chenhongbin1994/autool/辅助资料/模组驱动/USB/README.TXT

实验器材:
	战舰STM32F103开发板V3版本
	
实验目的:
	学习STM32的USB功能使用,实现一个USB虚拟串口功能.
	
硬件资源:
	1,DS0(连接在PB5)
	2,串口1(波特率:115200,PA9/PA10连接在板载USB转串口芯片CH340上面
	3,ALIENTEK 2.8/3.5/4.3/7寸TFTLCD模块(通过FSMC驱动,FSMC_NE4接LCD片选/A10接RS) 
	4,USB_SLAVE接口(通过跳线帽将D-/D+连接在PA11/PA12上)
	
实验现象:
	本实验，利用STM32自带的USB功能,连接电脑USB,虚拟出一个USB串口，实现电脑和开发板的数据通信。
	本例程功能完全同实验4（串口实验），只不过串口变成了STM32的USB虚拟串口。当USB连接电脑（USB
	线插入USB_SLAVE接口），开发板将通过USB和电脑建立连接虚拟出一个串口（注意：需要先安装:光盘
	\6，软件资料\1，软件\STM32 USB虚拟串口驱动\VCP_V1.4.0_Setup.exe这个驱动软件），USB和电脑
	连接成功后，DS1常亮。在找到虚拟串口后，即可打开串口调试助手，实现同实验4一样的功能，即：
	STM32通过USB虚拟串口和上位机对话，STM32在收到上位机发过来的字符串（以回车换行结束）后，原原
	本本的返回给上位机。下载后，DS0闪烁，提示程序在运行，同时每隔一定时间，通过USB虚拟串口输出一
	段信息到电脑。  
	
注意事项:
	1,4.3寸和7寸屏需要比较大电流,USB供电可能不足,请用外部电源适配器(推荐外接12V 1A电源).
	2,本例程在LCD_Init函数里面(在ILI93xx.c),用到了printf,如果不初始化串口1,将导致液晶无法显示!!
	3,本实验需安装:光盘\6，软件资料\1，软件\STM32 USB虚拟串口驱动\VCP_V1.4.0_Setup.exe这个驱动
	4,如果电脑显示驱动安装不正常（有惊叹号），请手动选择驱动安装，驱动路径（以WIN7系统为例）：C:\
	  Program Files (x86)\STMicroelectronics\Software\Virtual comport driver\Win7
	5,本例程USB线需要插在:USB_SLAVE,并确保P9的D-/D+通过跳线帽连接在PA11/PA12.

-------------------------------------------------------------------------------------------
◆其他重要连接：
  开发板光盘资料下载地址（视频+文档+源码等）：http://www.openedv.com/posts/list/13912.htm
  添加微信公众平台方法：http://www.openedv.com/posts/list/45157.htm

◆友情提示：如果您想以后及时免费的收到正点原子所有开发板资料更新增加通知，请关注微信公众平台：

 2种添加方法：（动动手提升您的学习效率，惊喜不断哦）
（1）打开微信->添加朋友->公众号->输入“正点原子”->点击关注
（2）打开微信->添加朋友->输入“alientek_stm32"->点击关注

 具体微信添加方法，请参考帖子：http://www.openedv.com/posts/list/45157.htm

			正点原子@ALIENTEK 
			广州市星翼电子科技有限公司
			电话：020-38271790
			传真：020-36773971
			购买：http://eboard.taobao.com
			公司网站：www.alientek.com
			技术论坛：www.openedv.com
