chenhongbin1994/autool/PT50摩托车四缸平衡仪表/按键逻辑.docx

按键0控制：POWER 单击开/关背光、长按开/关机

按键1控制：UP 单击向上翻动，长按开关蜂鸣器

按键2控制：REC 点按进入REC模式，再次点按为保存数据；长按进入查看历史数 据，再次单击REC键进入子模式查看最大最小值和差值

按键3控制：LOCK 单击锁定和解锁数据，长按保存OK；

按键4控制：DOWN 单击向下翻动、长按进入设置模式：

a.允许切换单位

b.设置2T和4T的模式

C.是否开启自动关机功能

在设置模式中，通过按键二和按键五向上、向下翻动切换锁定的通道， 在设置模式下长按按键3保存设置结果并跳到下一个设置项；

按键5控制：P=0 单击ZERO清除时间计时、长按P=0，在历史数据模式下长按清除历史数据

Bootloader按键逻辑

按键0控制：POWER 单击开关背光，长按开关机

按键1控制：UP

按键2控制：REC 单击开始更新固件

按键3控制：LOCK 单击开始执行flash APP，长按开始执行SRAM APP

按键4控制：DOWN

按键5控制：P=0 单击固件清除完成
