chenhongbin1994/autool/辅助资料/C391040_蜂鸣器_FUET-9045_规格书_FUET(福声科技)蜂鸣器规格书(1).PDF

泰州福声电子科技有限公司-----电声产品专业制造商
FUSHENG ELECTRONICS------Acoustic Components Professional Manufacturer

FST-9045

## SPECIFICATION OF PRODUCT 承 认 书

CUSTOMER:

DESCRIPTION： | Magnetic Buzzer
FUSHENG P/N: | FUET-9045

CUSTOMER P/N:

DATE： | 2018-8-28
CUSTOMER | APPROVER | CHECKER
| Yunqing Wu | Bing Yan

泰州福声电子科技有限公司

地址:江苏省泰州市海陵区凤凰西路168 号
电话：0086-523-86219066传真：0086-523-81601108 邮箱: sales@electronic-tech.cn 网址：www.tzfsdz.com

### 1.SPECIFICATION 规格

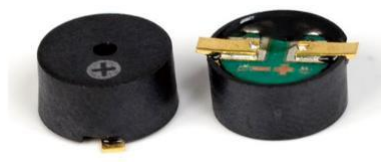
[picture p1: figure]

No. | Item | Unit | Specification | Condition
1 | Oscillation Frequency | Hz | 2700 | Vo-p=1/2duty ,square wave
2 | Operating Voltage | Vo-p | 2 ~ 4
3 | Rated Voltage | Vo-p | 3
4 | Current Consumption | mA | MAX. 80 | at Rated Voltage
5 | Sound Pressure Level | dB | MIN. 85 | at 10cm at Rated Voltage
6 | Coil Resistance | Ω | 16±3
7 | Operating Temperature | ℃ | -20 ~ +70
8 | Storage Temperature | ℃ | -30 ~ +80
9 | Dimension | mm | 9 xH4.5 | See appearance drawing
10 | Weight (MAX) | gram | 0.8
11 | Housing Material | | LCP( Black )
12 | Leading Pin | | Tin Plated Brass(Sn) | See appearance drawing
13 | Environmental Protection Regulation | | RoHS

### 2. APPEARANCE DRAWING 尺寸图

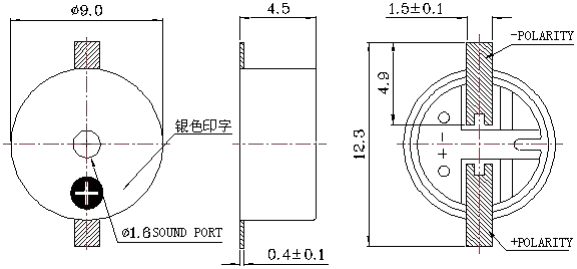
[picture p2: figure]

Tol:± 0.5 Unit:mm

### 3.TESTING METHOD 测量方式 Standard Measurement conditions

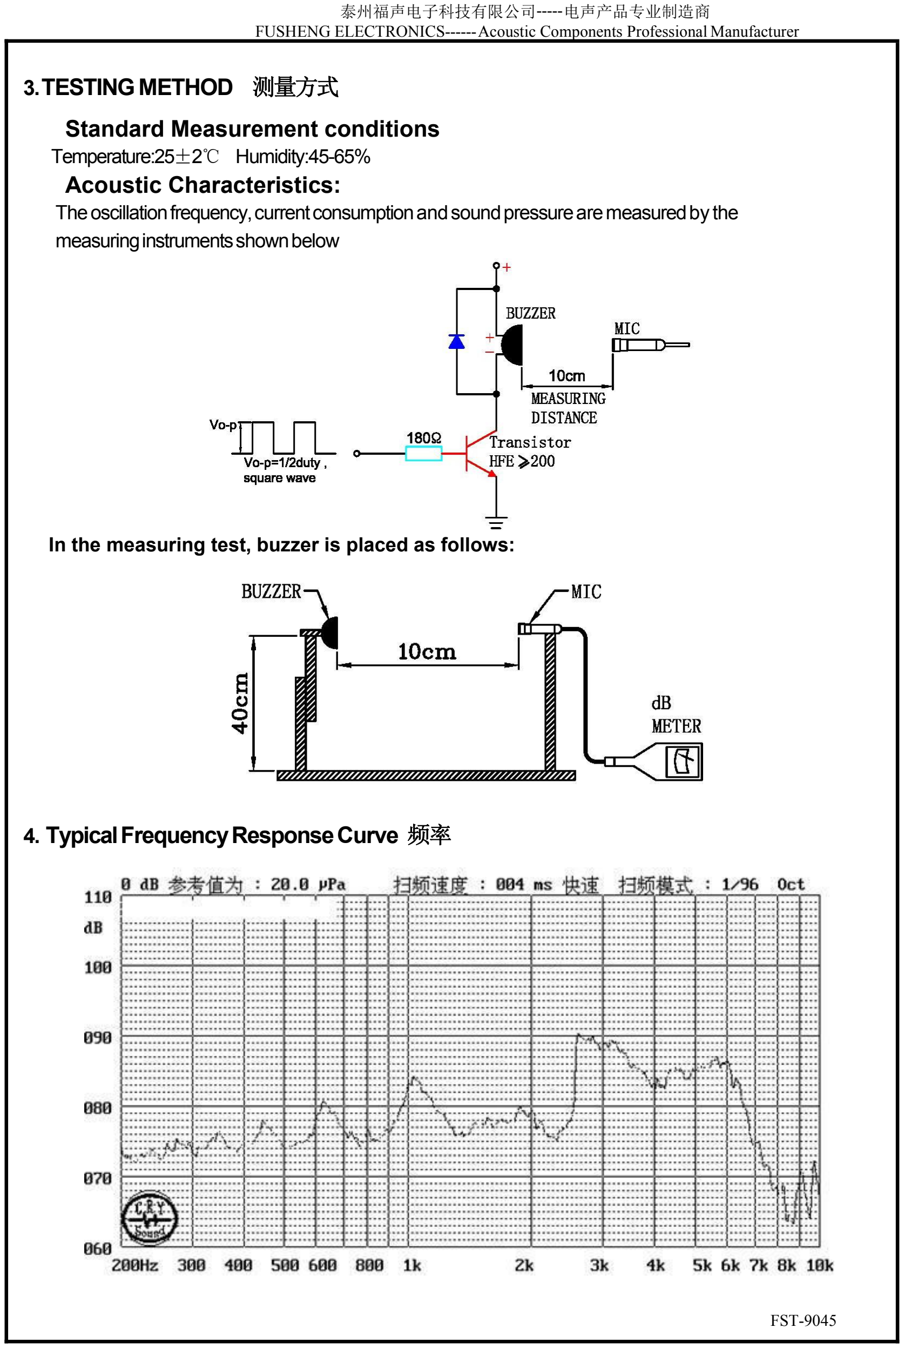
[picture p3: page 3]

Temperature:25±2℃ Humidity:45-65%

### Acoustic Characteristics:

Theoscillationfrequency,currentconsumptionandsoundpressurearemeasuredby the measuringinstrumentsshownbelow

In the measuring test, buzzer is placed as follows:

### 4. TypicalFrequencyResponseCurve 频率

### 5. Recommend DrivingCircuit

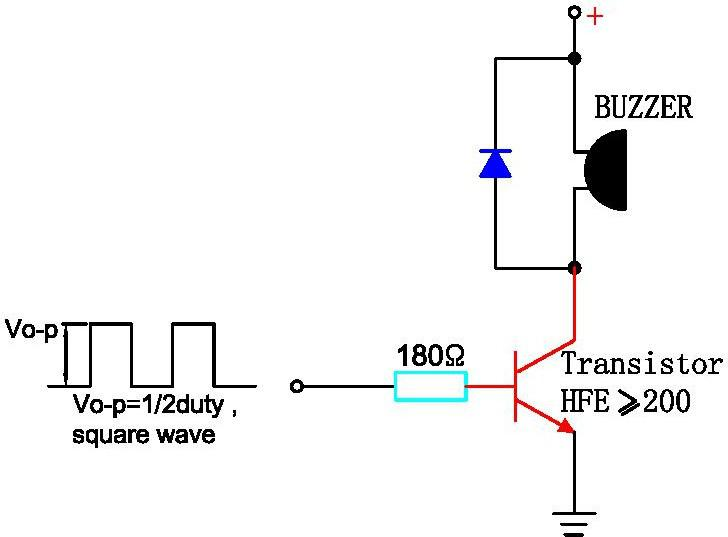
[picture p4: figure]

### Thebase currentIbshouldhighenoughso thatitsaturatesthe collectorcurrentofthe transistor

### withtheCBload. 6. SolderingCondition

(1)Recommendablereflowsolderingconditionis as follows (Reflowsolderingis twice)
Note:Itis requestedthatreflowsolderingshouldbeexecuted afterheatofproductgoesdownto normal.

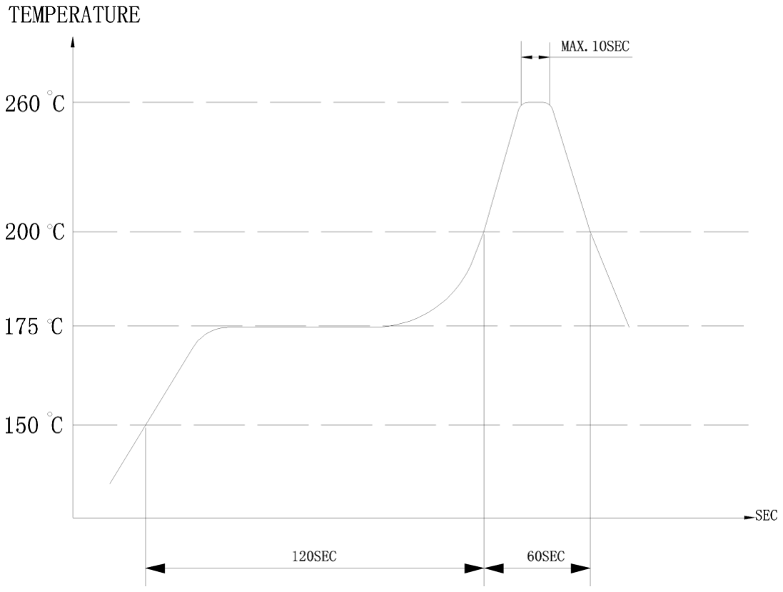
[picture p5: figure]

Heat resistant line
(Usedwhenheatresistantreliabilitytestis performed) (2)Manualsoldering
Manual soldering temperature 350 ºC within 5 sec.

### 7. RELIABILITYTEST 可靠性测试

NO. | ITEM | TEST CONDITION AND REQUIREMENT
1 | High Temperature Low Temperature Test(Storage) | Afterbeingplacedina chamberwith80 2ºCfor96hoursandthen beingplacedinnormalconditionfor2 hours. AllowablevariationofSPLaftertest: 10dB. 2
| Humidity Test Test(Storage) | AfterbeingPlacedina chamberwith-30 2ºCfor96hoursandthen beingplacedinnormalconditionfor2 hours. AllowablevariationofSPLaftertest: 10dB. 3
| | AfterbeingPlacedina chamberwith90-95%R.H.at40 2ºC for96 hoursandthenbeingplacedinnormalconditionfor2 hours. AllowablevariationofSPLaftertest: 10dB.
4 | TemperatureCycle Test Drop Test | The part shall be subjected to 5 cycles. One cycle shall be consist of： +70ºC +25ºC +25ºC - 20ºC AllowablevariationofSPLaftertest: 10dB. 5

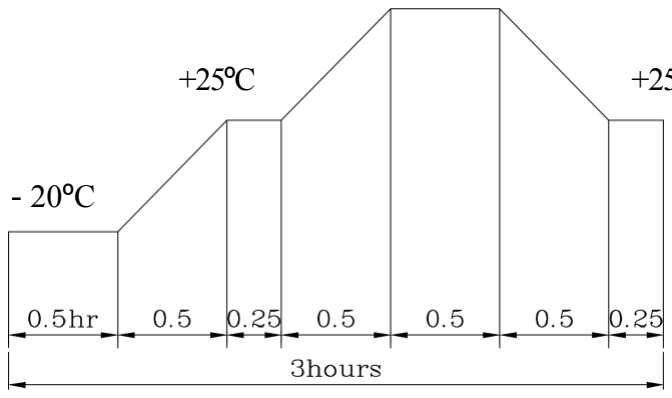
[picture p6: figure]

| Vibration Test | Dropona hardwoodboardof4cmthick,anydirections,6times, attheheightof75cm. AllowablevariationofSPLaftertest: 10dB. 6
Solderability | Afterbeingappliedvibrationof amplitudeof1.5mmwith10to55Hz band of vibration frequency to each of 3 perpendicular directionsfor 2hours. AllowablevariationofSPLaftertest: 10dB. 7
Test TerminalStrength | Lead terminals are immersed in rosin for 5 seconds and then immersedinsolderbathof+300 5ºCfor3 1seconds. 90%min.leadterminalsshallbewetwithsolder (Excepttheedgeofterminals). 8
PullingTest | Theforceof9.8N(1.0kg)is appliedtoeachterminalinaxialdirectionfor 10seconds. No visible damage and cutting off. TEST CONDITION. Standard Test Condition 一般测试条件

JudgmentTestCondition
争议时测试条件
: | a)Temperature: +5~ +35℃ b) Humidity : 45-85% c) Pressure : 860-1060mbar
: | a) 温度 : +5 ~ +35℃ | b) 湿度 : 45-85% | c) 气压 : 860-1060mbar
: | a) Temperature: +25 ± 2℃ b) Humidity : 60-70% c) Pressure : 860-1060mbar
: | a) 温度 : +25 ± 2℃ | b) 湿度 : 60-70% | c) 气压 : 860-1060mbar

### 8. PACKINGSTANDARD 包装

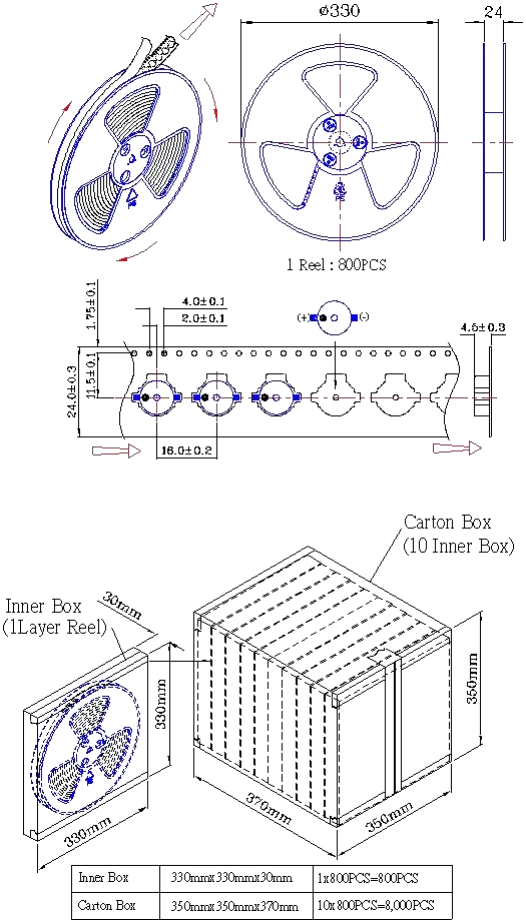
[picture p7: figure]
