chenhongbin1994/autool/PT50摩托车四缸平衡仪表/HT1623断码屏/四缸平衡UI.jpg

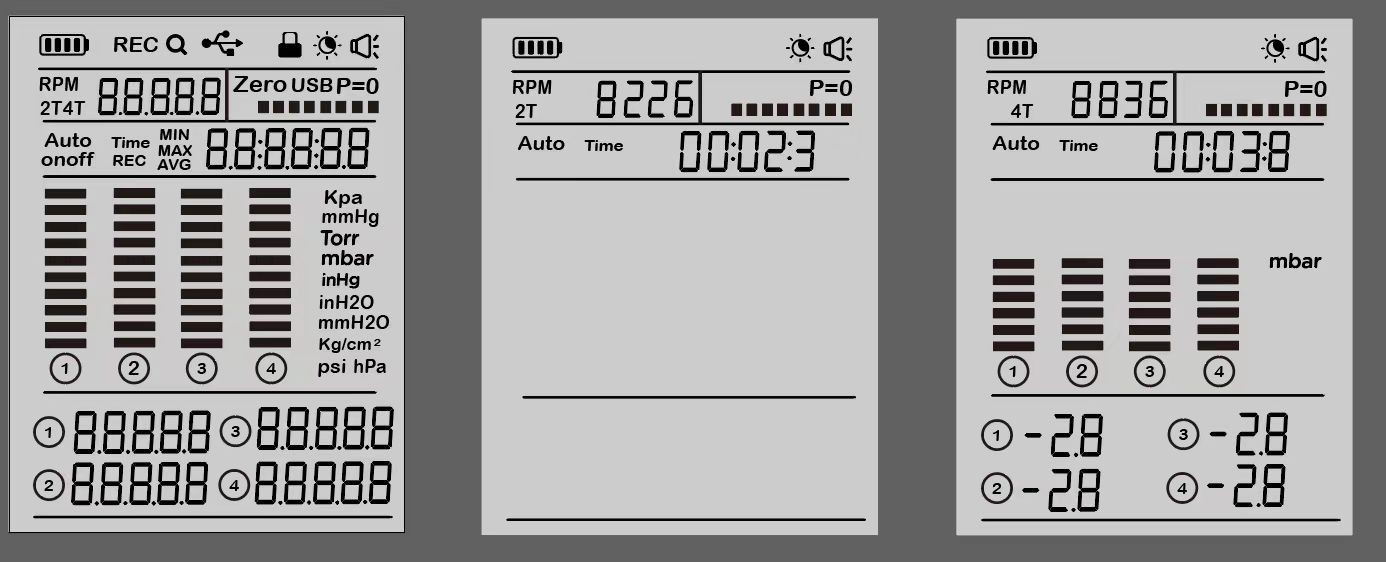
PT50摩托车四缸平衡仪表/HT1623断码屏/四缸平衡UI.jpg
