chenhongbin1994/autool/PT50 摩托车四缸平衡仪buglist_20240810.xlsx

摩托车四缸平衡仪测试
产品名称 |  | 摩托车四缸平衡仪 | 测试型号 | PT50 | 拟制日期 | 2024.08.09
软件版本 |  | V1.0 | 测试人员 | 吴思 | 测试数量 | 1 pcs
测试场景：
编号 | 模块 | 测试步骤/内容 |  | 期望结果 |  | 优先级 | 测试结果 | 备注/问题描述 | 验证
1 | 四缸排序 | 四个接头对应屏幕显示的1234是如何排序的 |  | 预期结果：从左到右依次排列 |  | P1 | FAIL
2 | 校准大气压 | 长按 P=0 键校准大气压时，第一个气缸的值不变，其余三个值归零 |  | 预期结果：校准大气压后，四个值都归零 |  | P1 | FAIL
3 | 设置 | 进入设置，在切换 2T 和 4T 模式时，显示是4T，点按上键切换，无反应，点击OK键后，返回界面，发现已从 4T 切换到 2T |  |  |  | P1 | FAIL
4 | 按键 | 点按 设置键 或 其他按键 多次 ，界面会随机显示 Auto，on，off，REC，Time等其他字符 |  |  |  | P1 | FAIL | 由于TIM3跟main文件while，可能会有冲突；解决办法：在main文件while下的关于显示处理部分都加上开关所有中断
5 | 按键 | 长按电源键关机，关机后，点按电源键多次，界面会出现字符，再点按电源键多次，会出现背光 |  |  |  | P1 | FAIL
6 | REC模式 | 点按REC进入记录模式，再次点按REC，记录每组数据，按到19组后，如果按键的速度比较快，会出现 10,11,12,3,4,5... |  |  |  | P1 | FAIL
7 | 设置 | 长按设置键进入切换单位，缺少cmHg，多 Torr，inH2O，mmH2O |  | 立项书中有此需求 |  | P1 | FAIL
8 | 设置 | 设置无中英文等多种语言切换，目前只英文一种显示 |  | 立项书中有此需求 |  | P1 | FAIL
9 | REC模式 | 查看某一组数据的Max，Min，差值；Max和Min显示有误，差值计算错误 |  | 如Max：888.3，Min：898，差值0.6 预期结果：Max：898，Min：888.3 差值9.7 |  | P1 | FAIL
10 | 计时 | 点按或长按 P=0 键时，Time 归零，不再计时 |  |  |  | P1 | FAIL
11 | 自动关机 | 无压力的情况下，没有等待几分钟后自动关机；也不能设置自动关机 |  | 其他产品有这个功能，评估是否加上 |  | P1 | FAIL
12 | REC模式 | 在查看上组数据的最大值，最小值时，如果是在查看Max点按REC进入下一组，在这组数据显示的会是Min，会从上一组的操作继续到下一组 |  |  |  | P1 | FAIL
13 | REC模式 | 在查看数据记录时，底下四组的值不会跟随上面的计数，产生变化 |  | 如上面的计数是7，切换到 8,9,10，底下四个值一直未变 |  | P1 | FAIL
14 | REC模式 | 在REC模式中，点按或长按 P=0 键，已记录的数据不会归零 |  | 如已记录到第5组，不想要前面的数据，点按或长按 P=0 键，数据不会被清掉，还会从第6组继续计数 |  | P1 | FAIL
15 | REC-查看模式 | 在REC-查看模式中，长按 P=0 键后，数据归零，点按下键，界面出现空白 |  |  |  | P1 | FAIL
16 | REC-查看模式 | 在REC-查看模式中，长按 P=0 键后，数据归零，点按上键，会出现压力值变化 |  |  |  | P1 | FAIL
17 | REC-查看模式 | 在REC-查看模式中，数据可查看20组，记录模式中是从0,1,2....19计数 |  |  |  | P1 | FAIL
