chenhongbin1994/autool/(list of files, cad)

Other CAD files:
辅助资料/断码屏资料/2382432233ht1621驱动/ht1621驱动/test_1621_66f50/main.OBJ
辅助资料/断码屏资料/2382432233ht1621驱动/ht1621驱动/test_1621_46r06x/main.OBJ
辅助资料/断码屏资料/2382432233ht1621驱动/ht1621驱动/test_1621_46r06x/Dispay Code-46R065 16NSOP.OBJ
辅助资料/第一版/TXD-61666编码图.dwg
辅助资料/断码屏资料/2382432233ht1621驱动/ht1621驱动/test_1621_46r06x/ht1621.OBJ
辅助资料/断码屏资料/2382432233ht1621驱动/ht1621驱动/test_1621_66f50/ht1621.OBJ
辅助资料/第一版/TXD-BL23A275W4-S承认书.dwg
辅助资料/断码屏资料/2382432233ht1621驱动/ht1621驱动/test_1621_66f50/Dispay Code-46R065 16NSOP.OBJ
