chenhongbin1994/autool/PT50摩托车四缸平衡仪表/四缸平衡仪第二版原理图.pdf

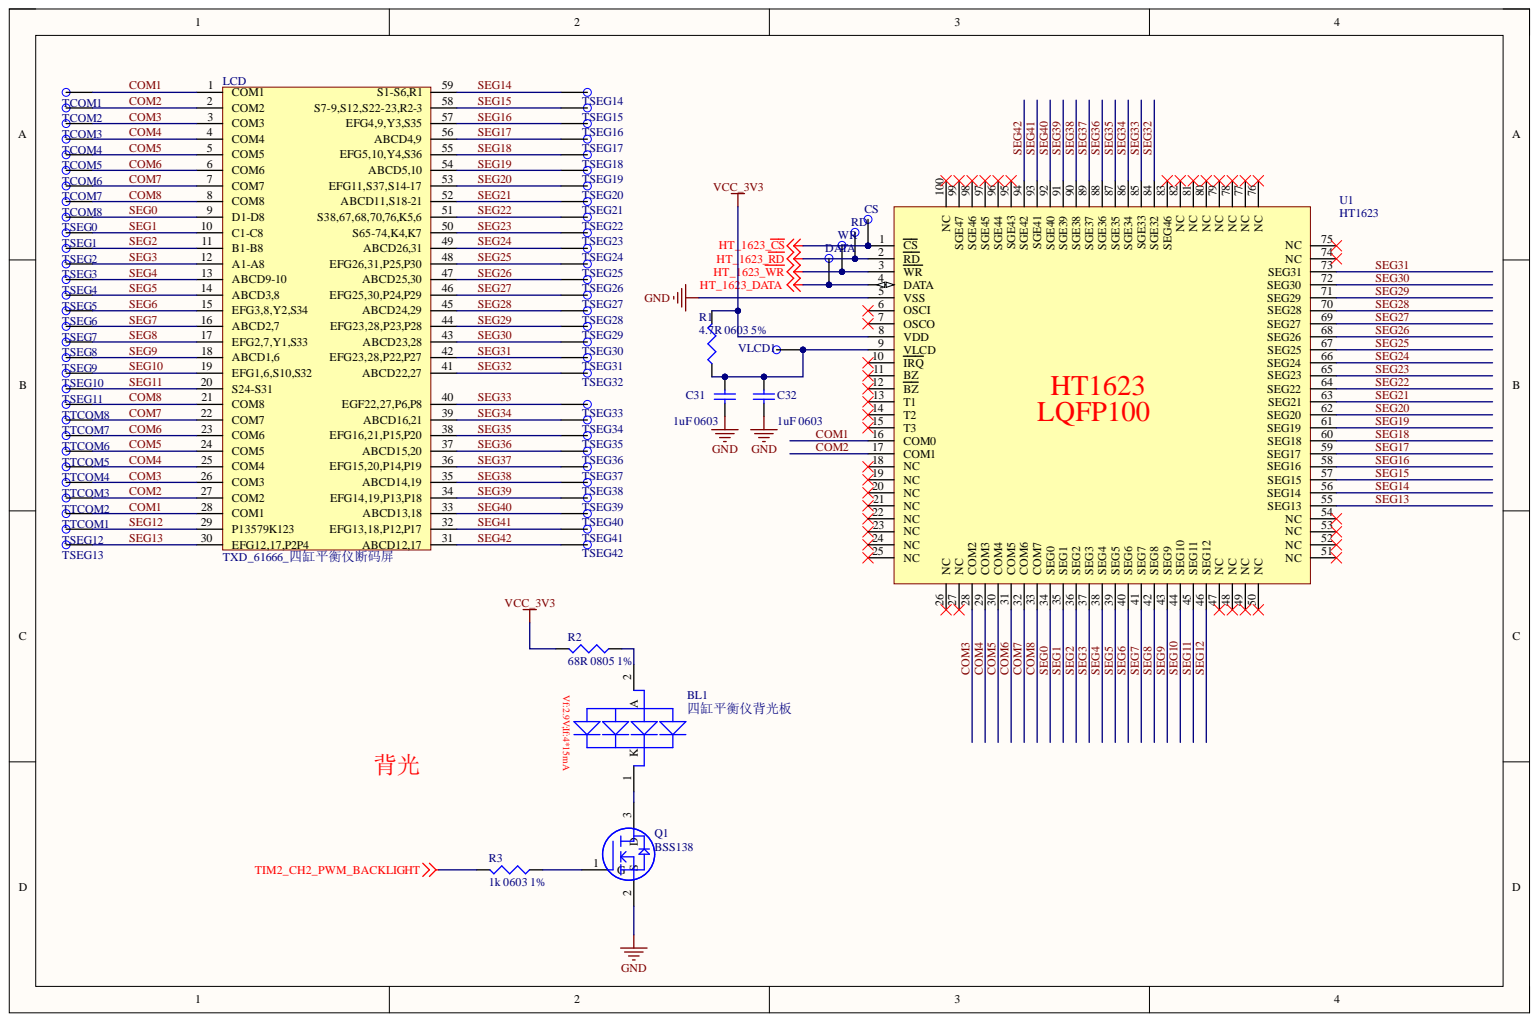
[picture p16: page 1]

NC 76 NC 77 NC 78 NC 79 NC 80 NC 81 NC 82 SEG46 83

4 5 SE G 2 8 | | 6
R1 4.7R 4 4 SE G 2 9 | 0 6 0 3 5 % | 7
4 3 SE G 3 0 | | 8

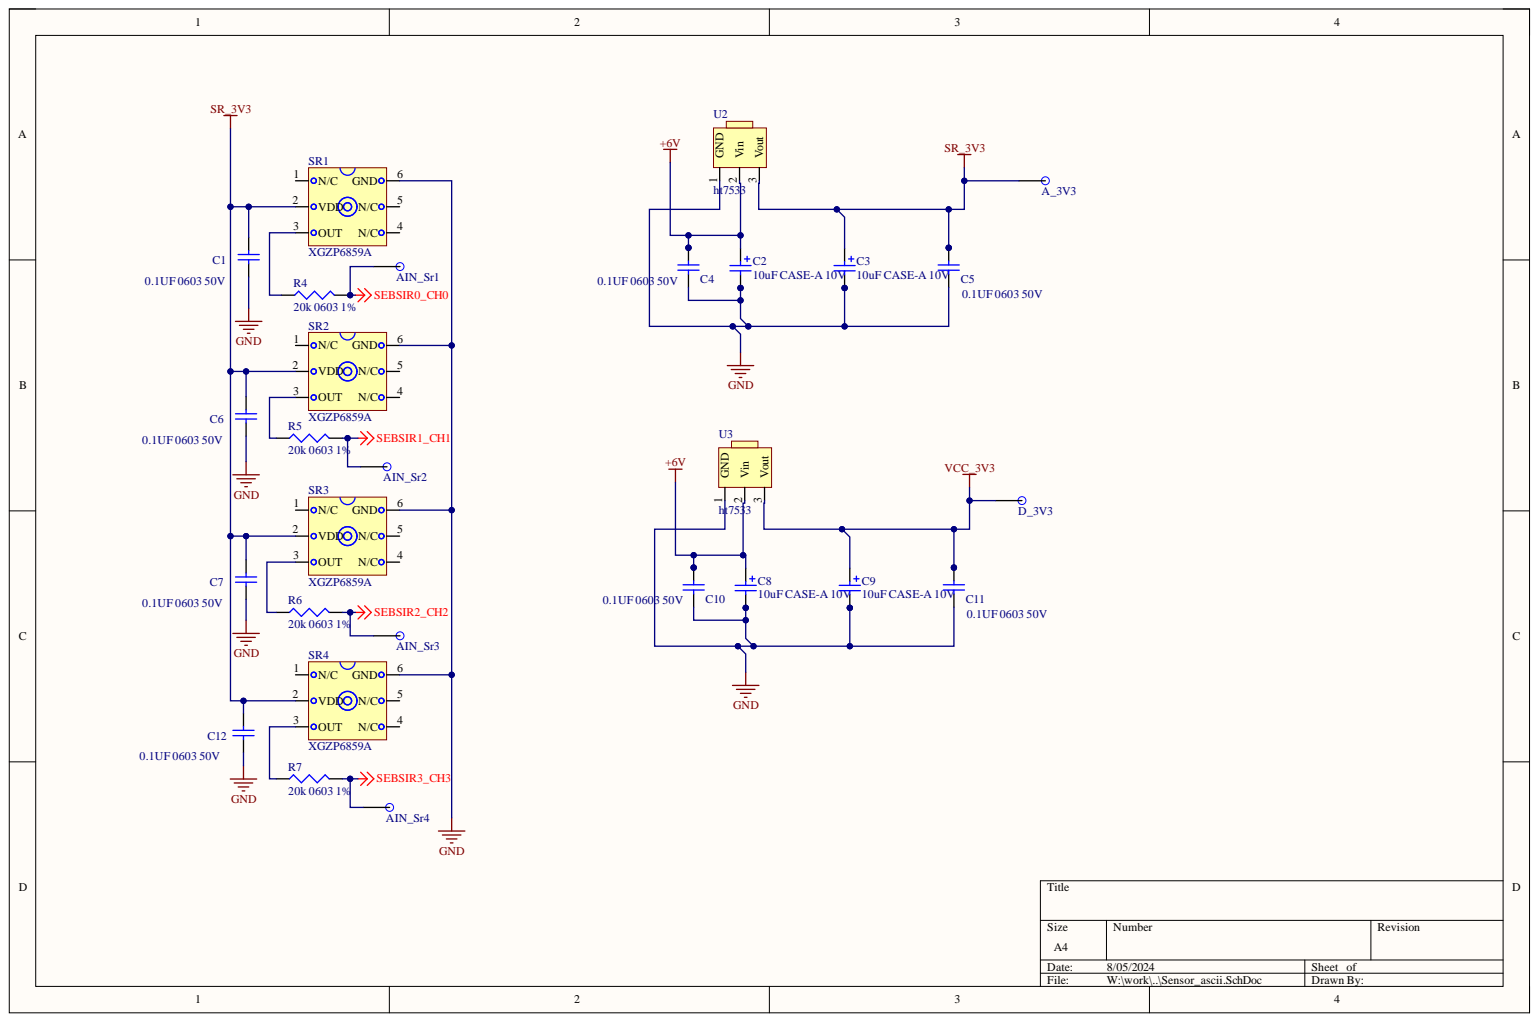
[picture p17: page 2]

2 | | | 5 AIN _Sr 1 _ C H 0

2 | | 5 AIN _Sr 3

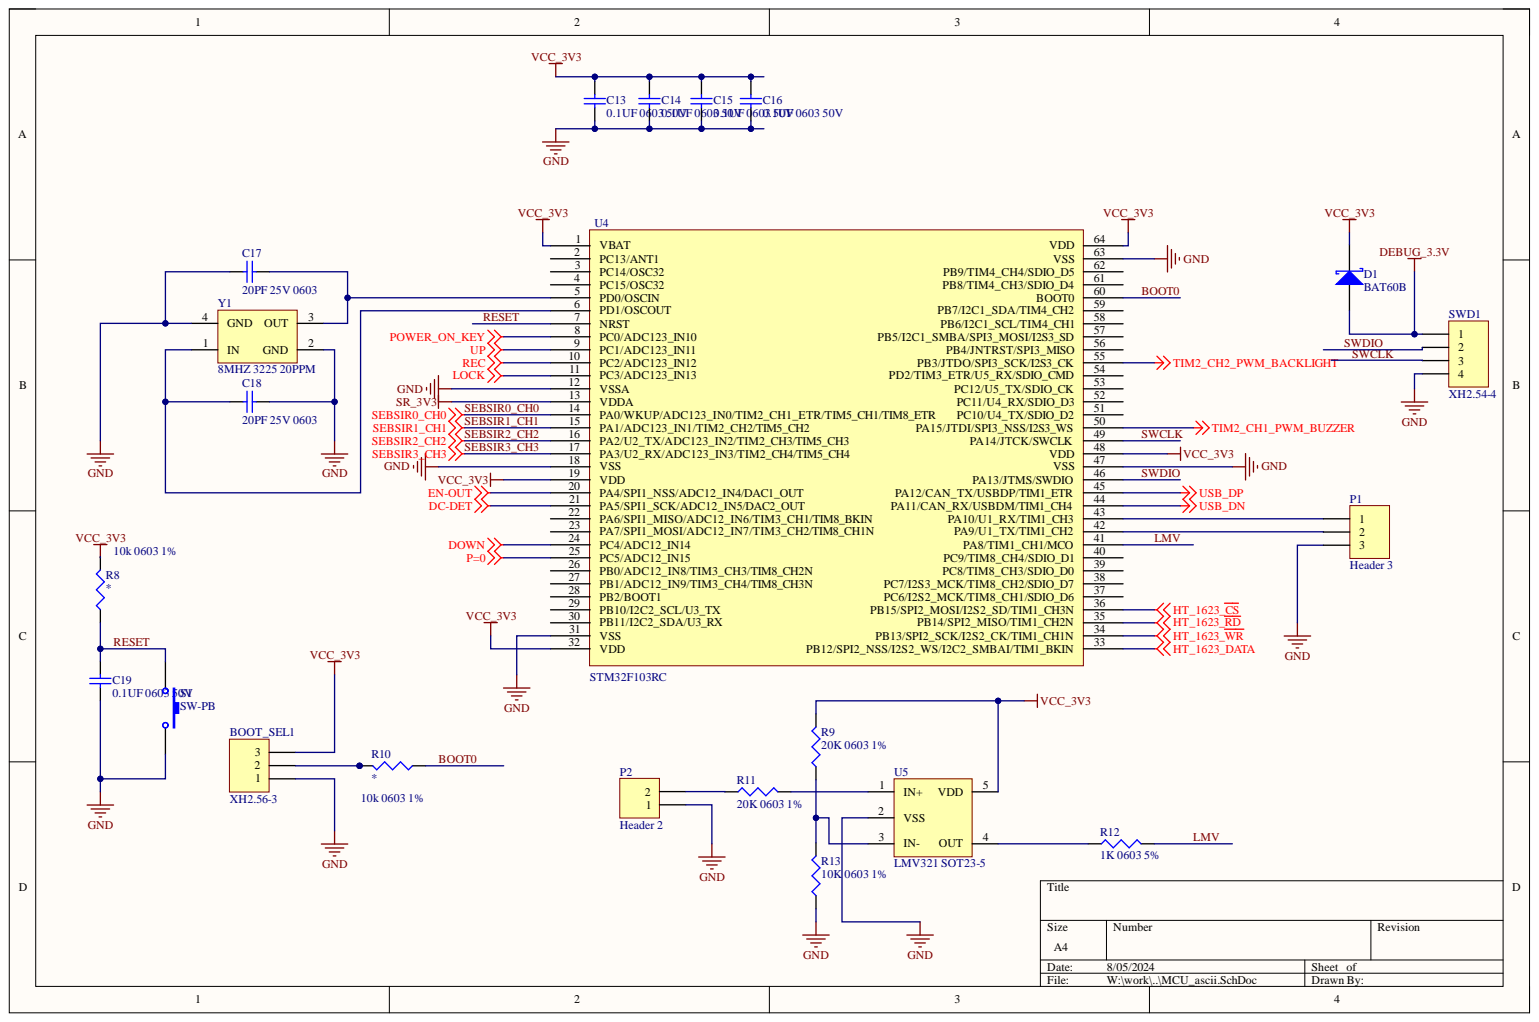
[picture p18: page 3]

PD1/OSCOUT 6
NRST 7 PC0/ADC123_IN10 8 PC1/ADC123_IN11 9 PC2/ADC123_IN12 10 PC3/ADC123_IN13 11 VSSA 12

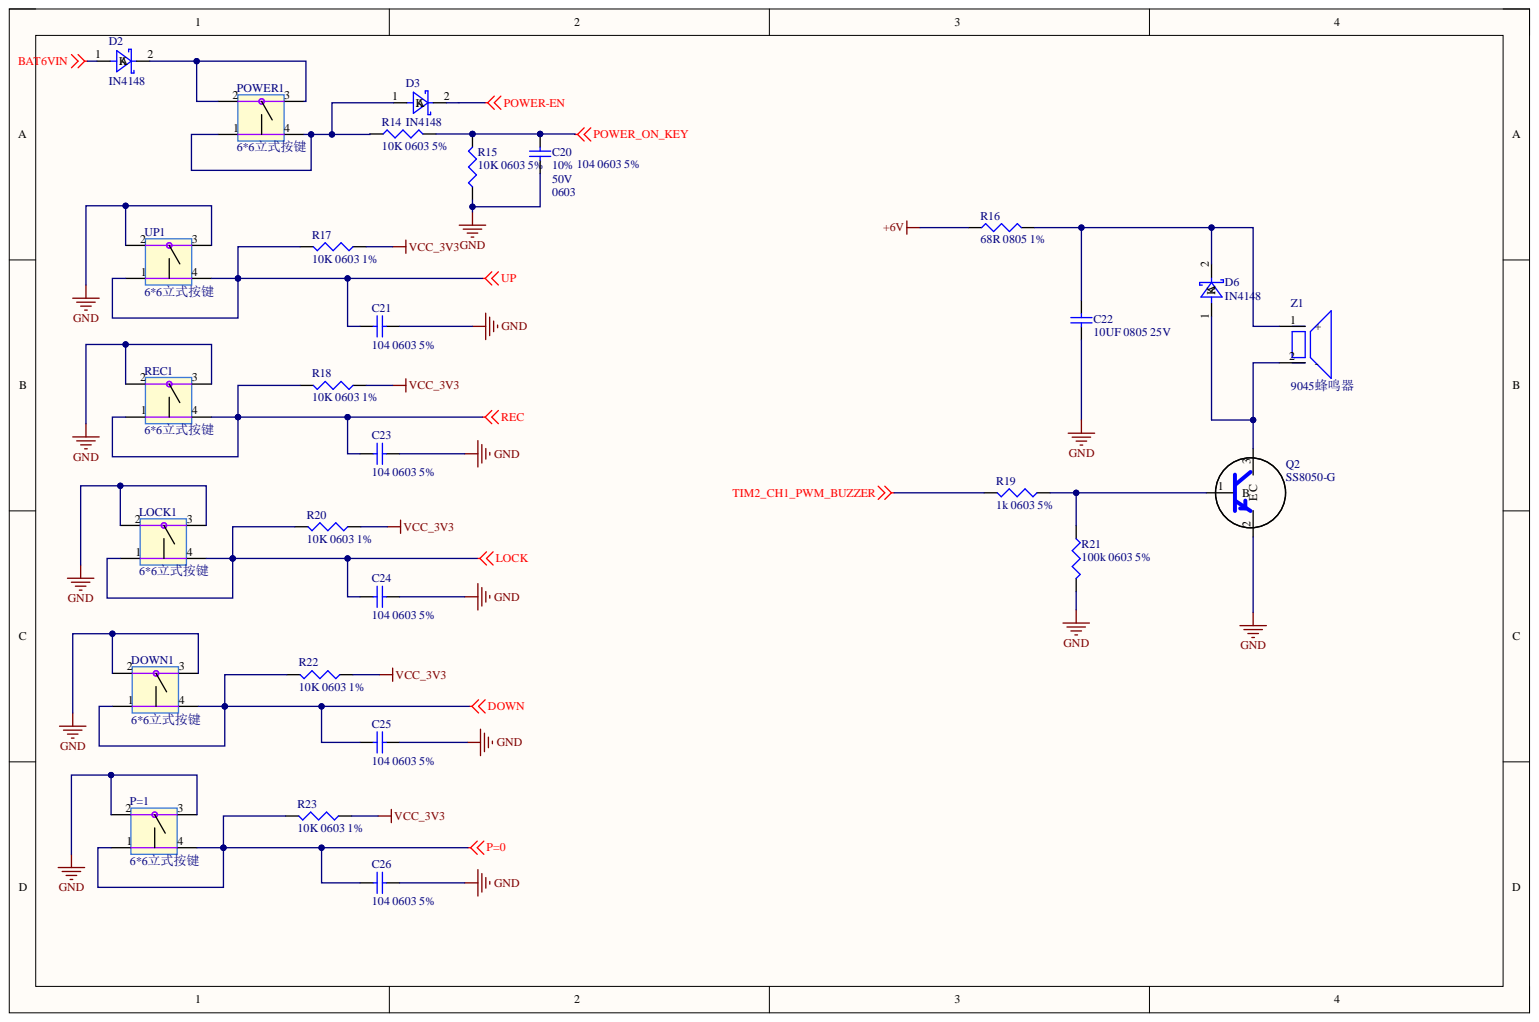
[picture p19: page 4]

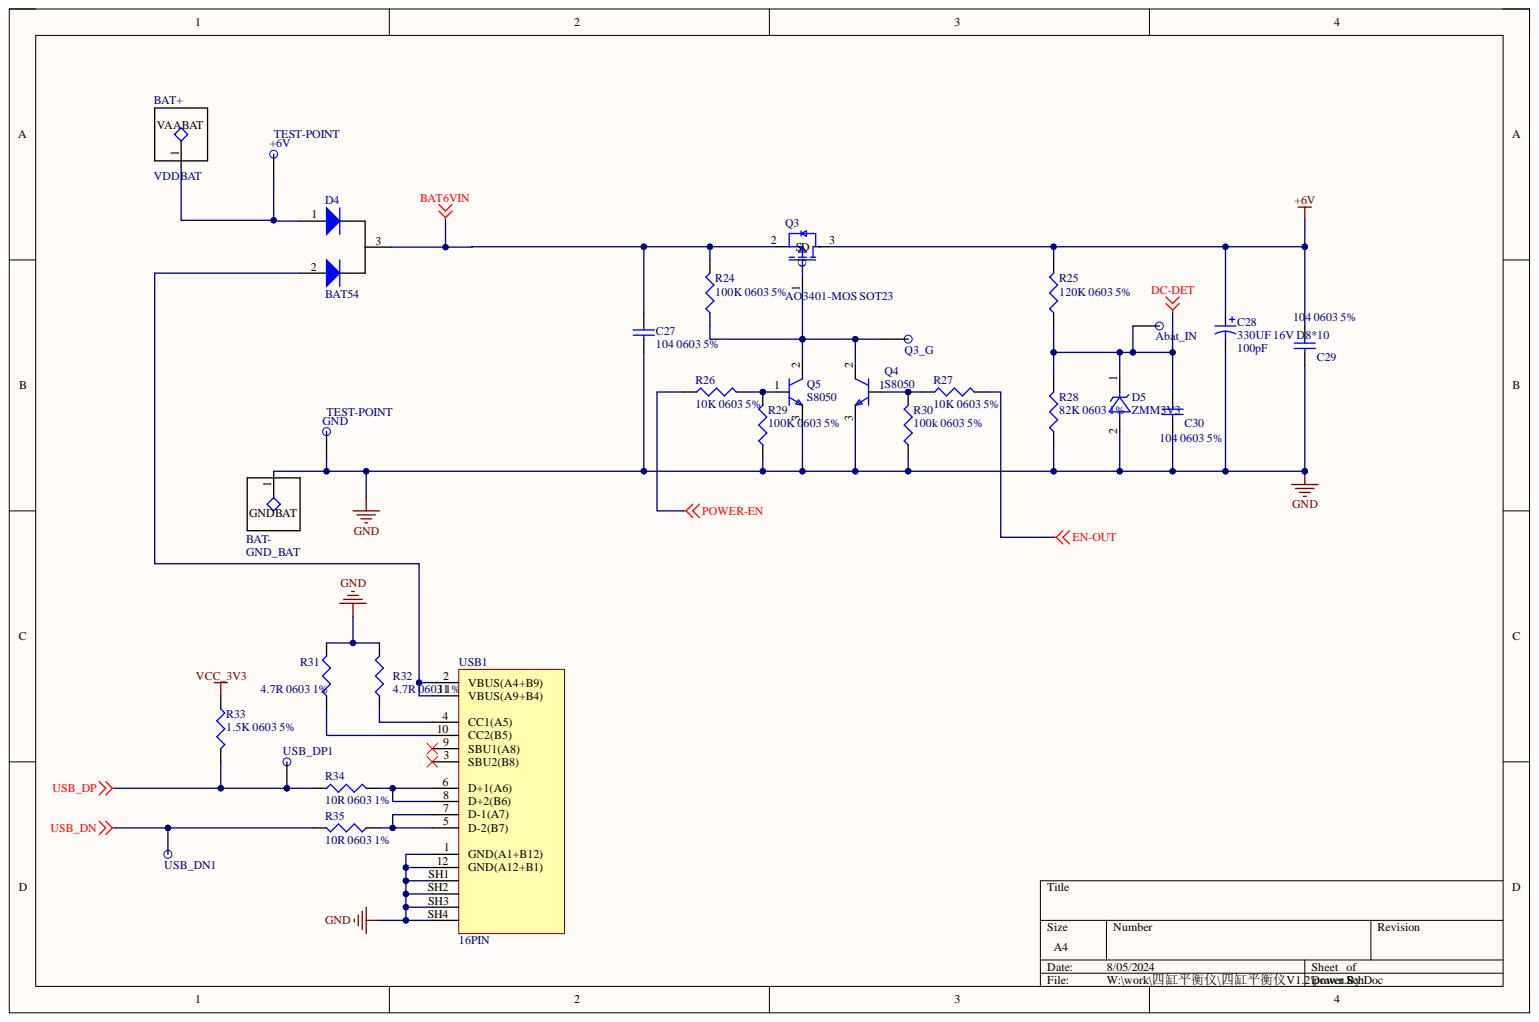
[picture p20: page 5]

D+2(B6) 8
D-1(A7) 7

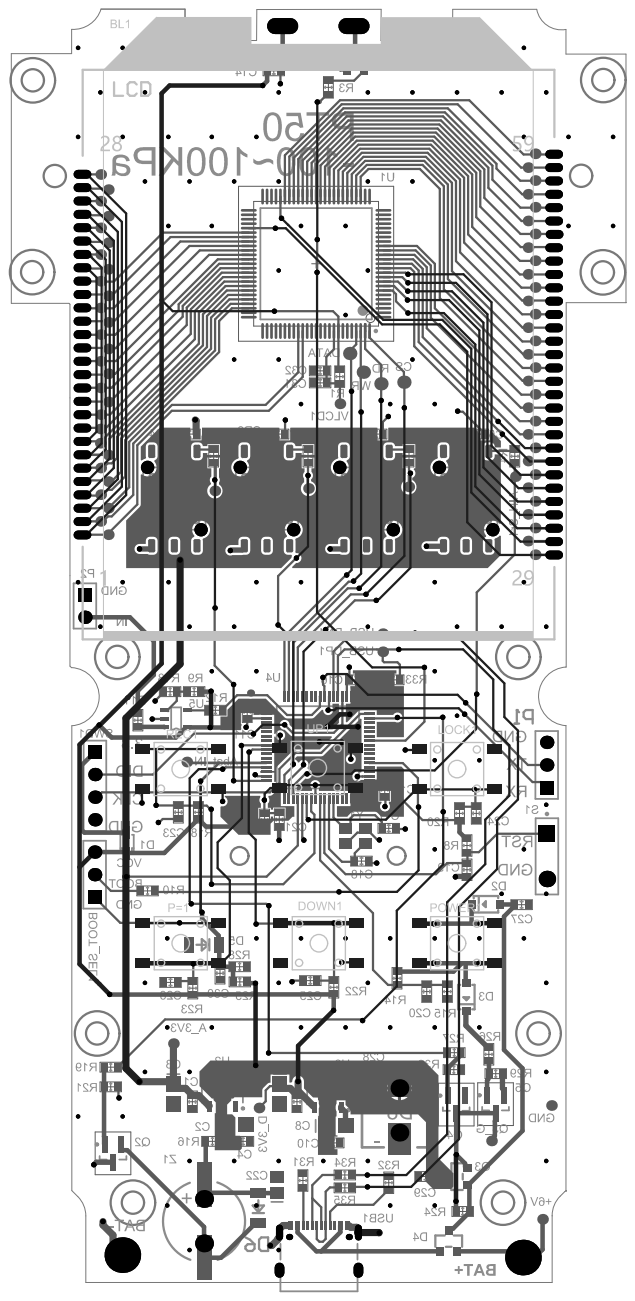
[picture p21: page 6]
