chenhongbin1994/autool/辅助资料/pt50黄最新.pdf

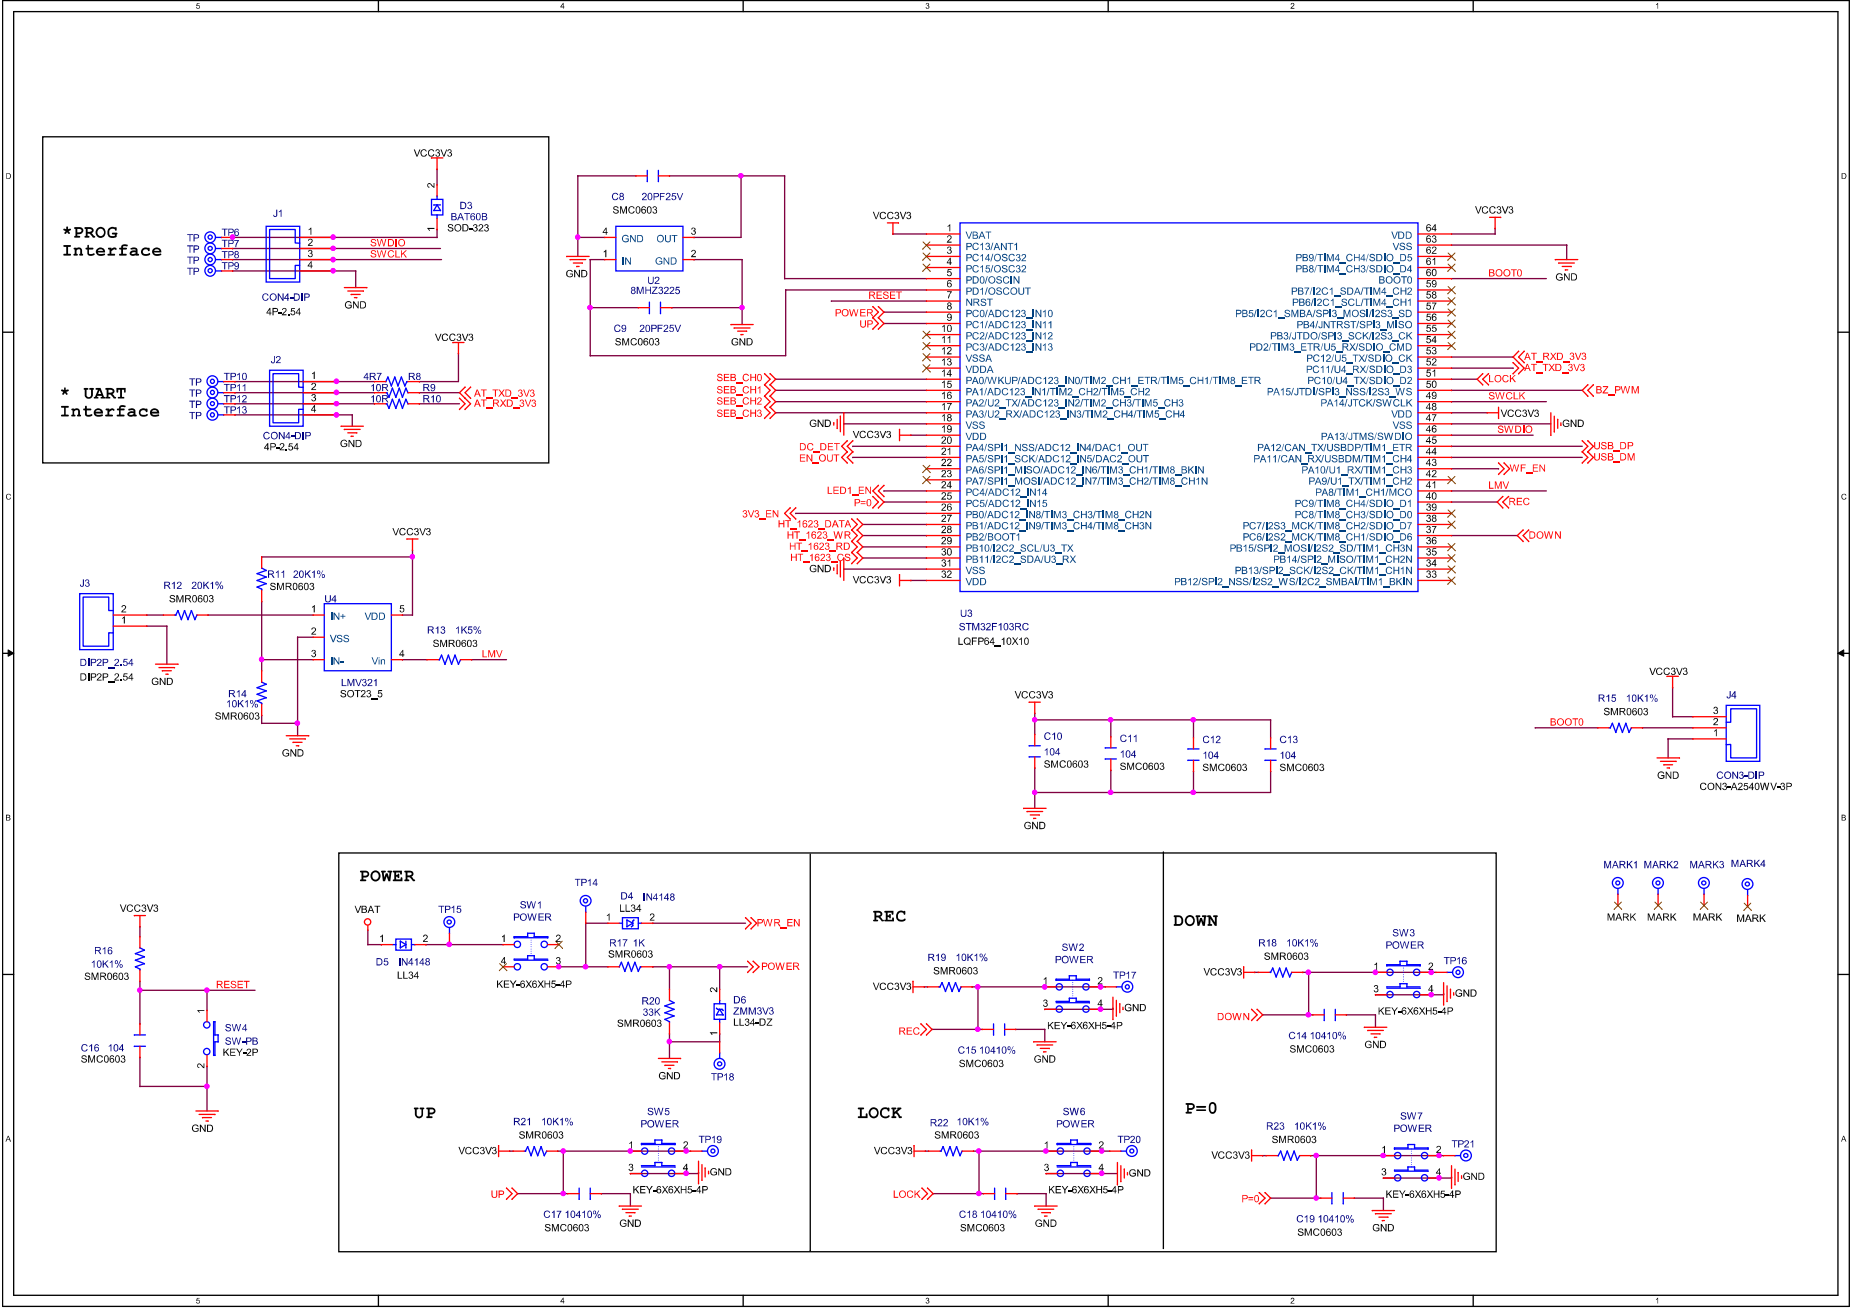
[picture p28: page 1]

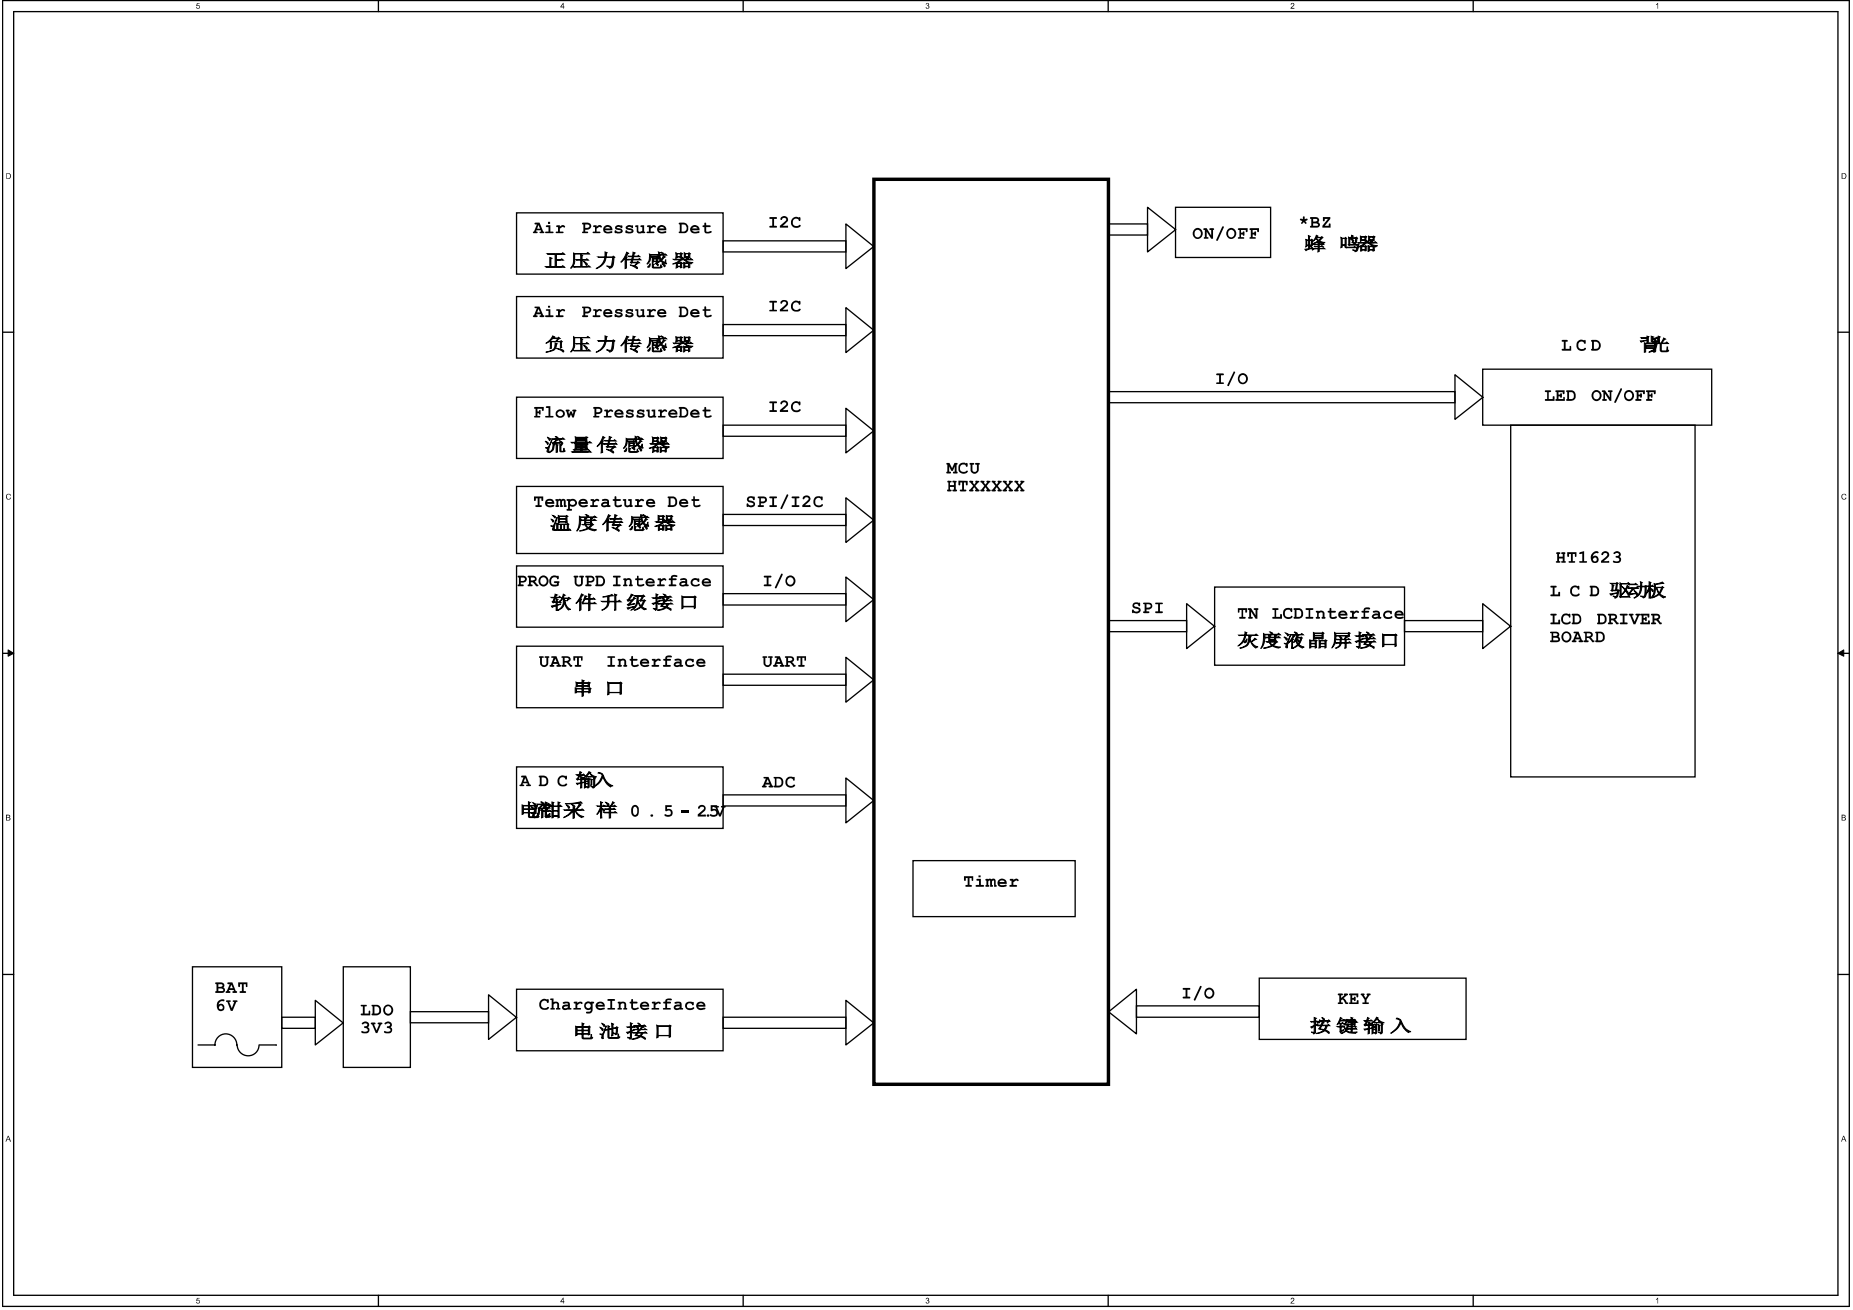
[picture p29: page 2]

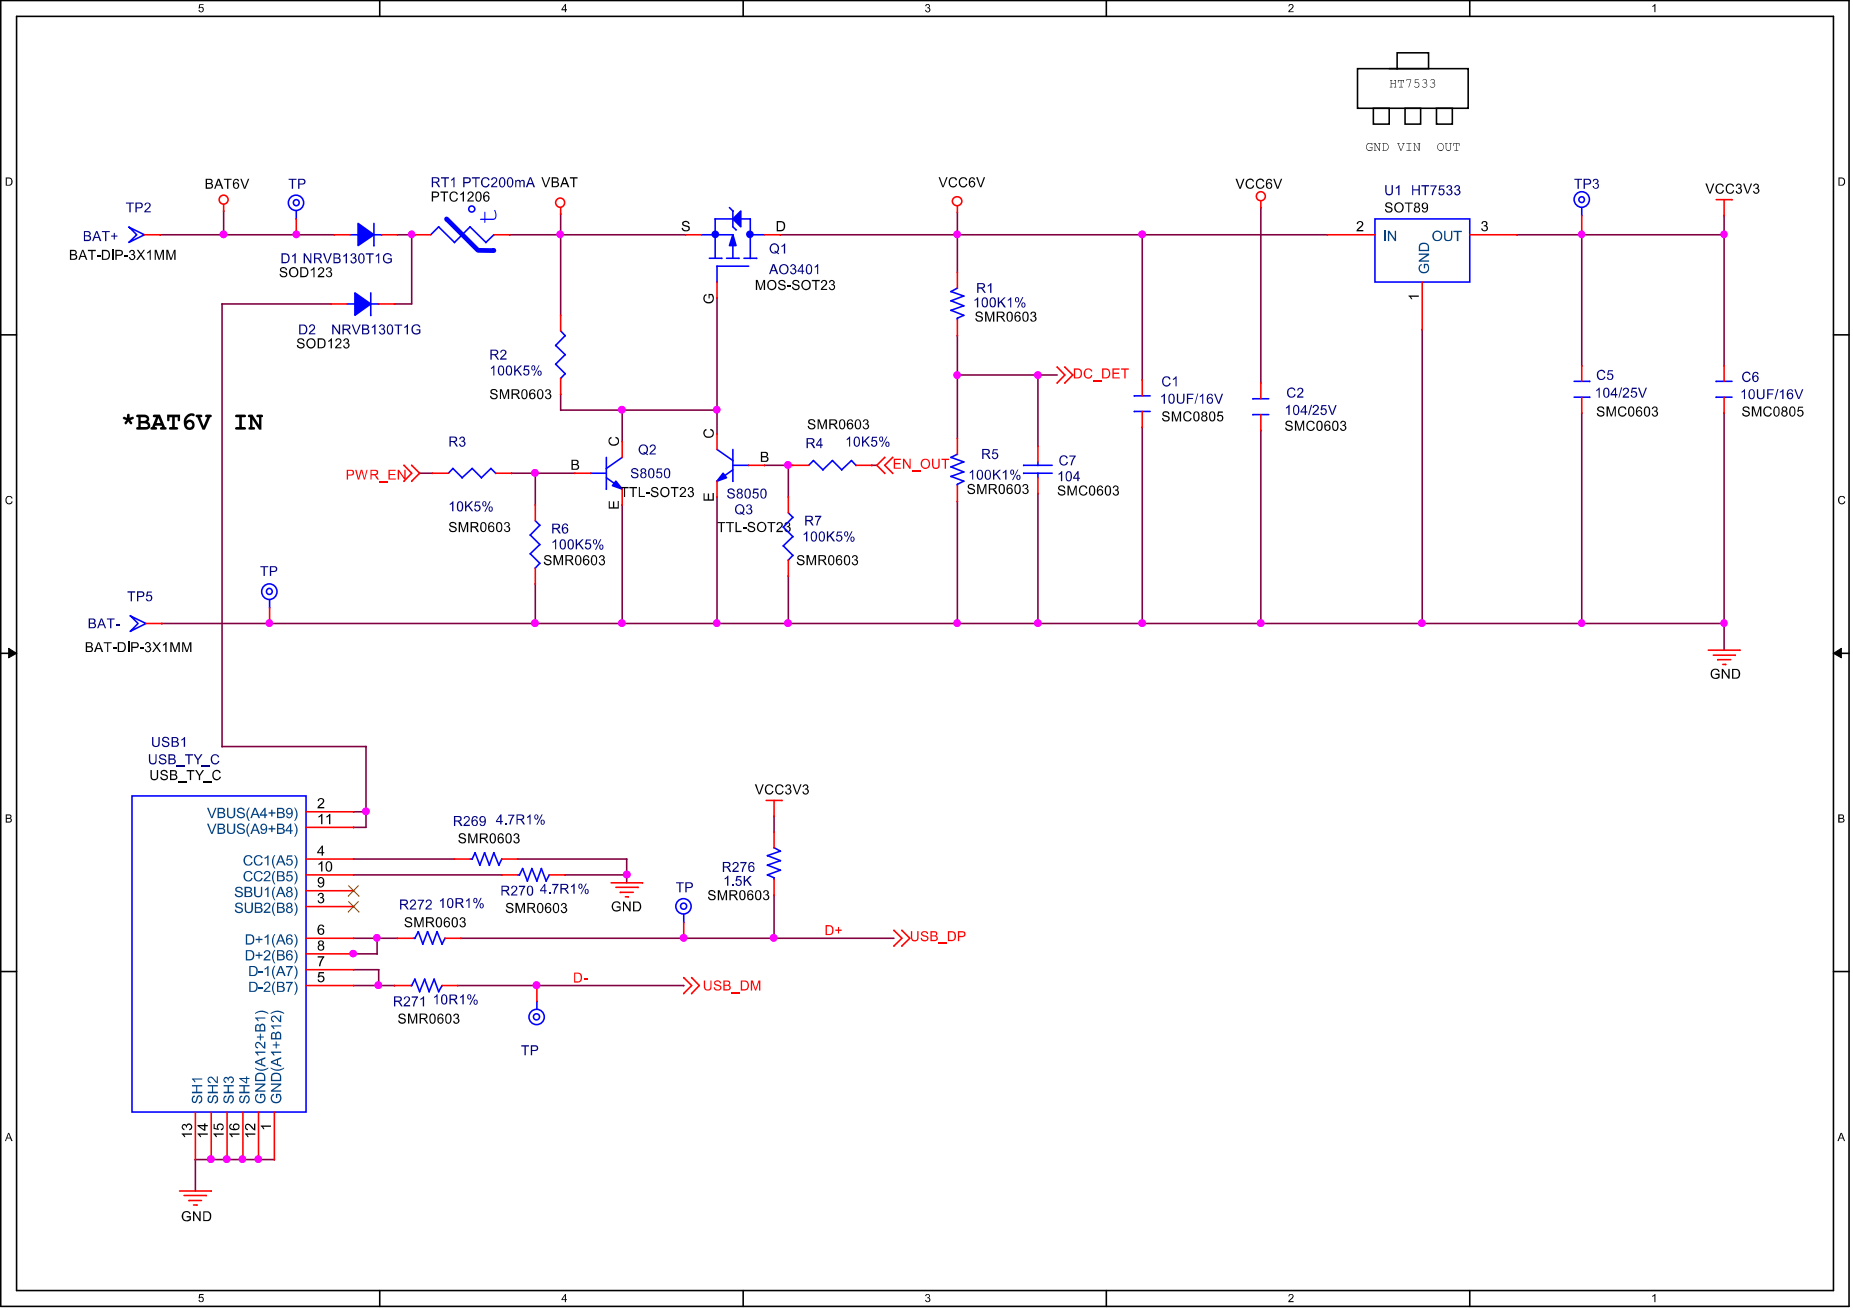
[picture p30: page 3]
