chenhongbin1994/autool/辅助资料/四缸平衡仪原理图A0.pdf

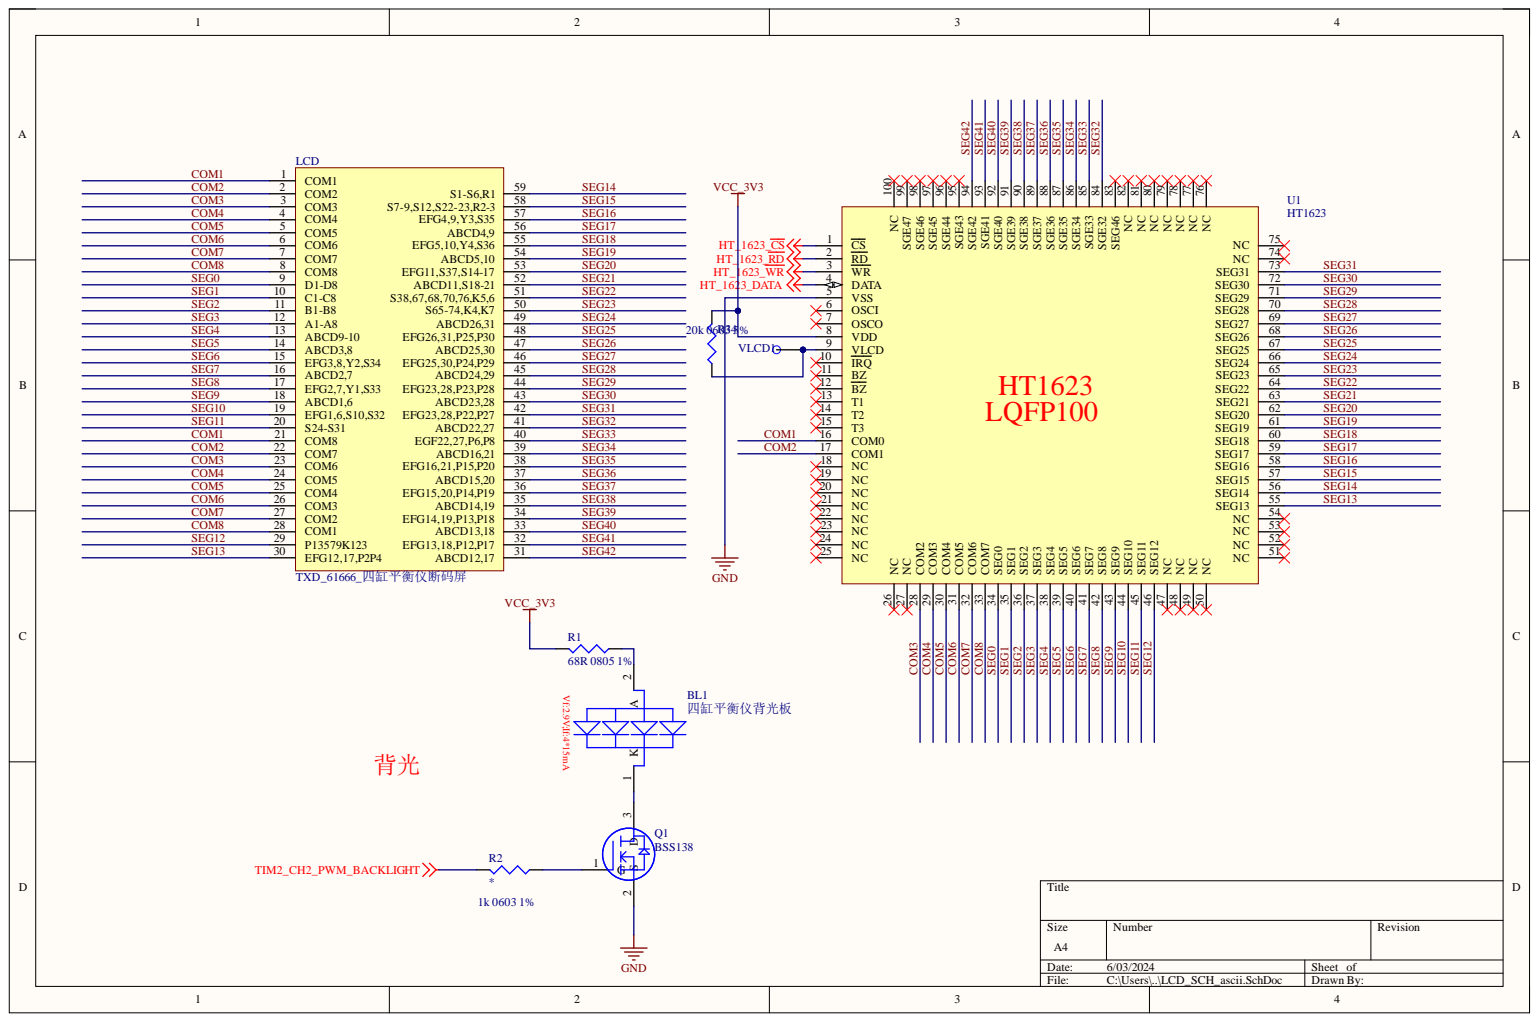
[picture p31: page 1]

NC 76 NC 77 NC 78 NC 79 NC 80 NC 81 NC 82 SEG46 83

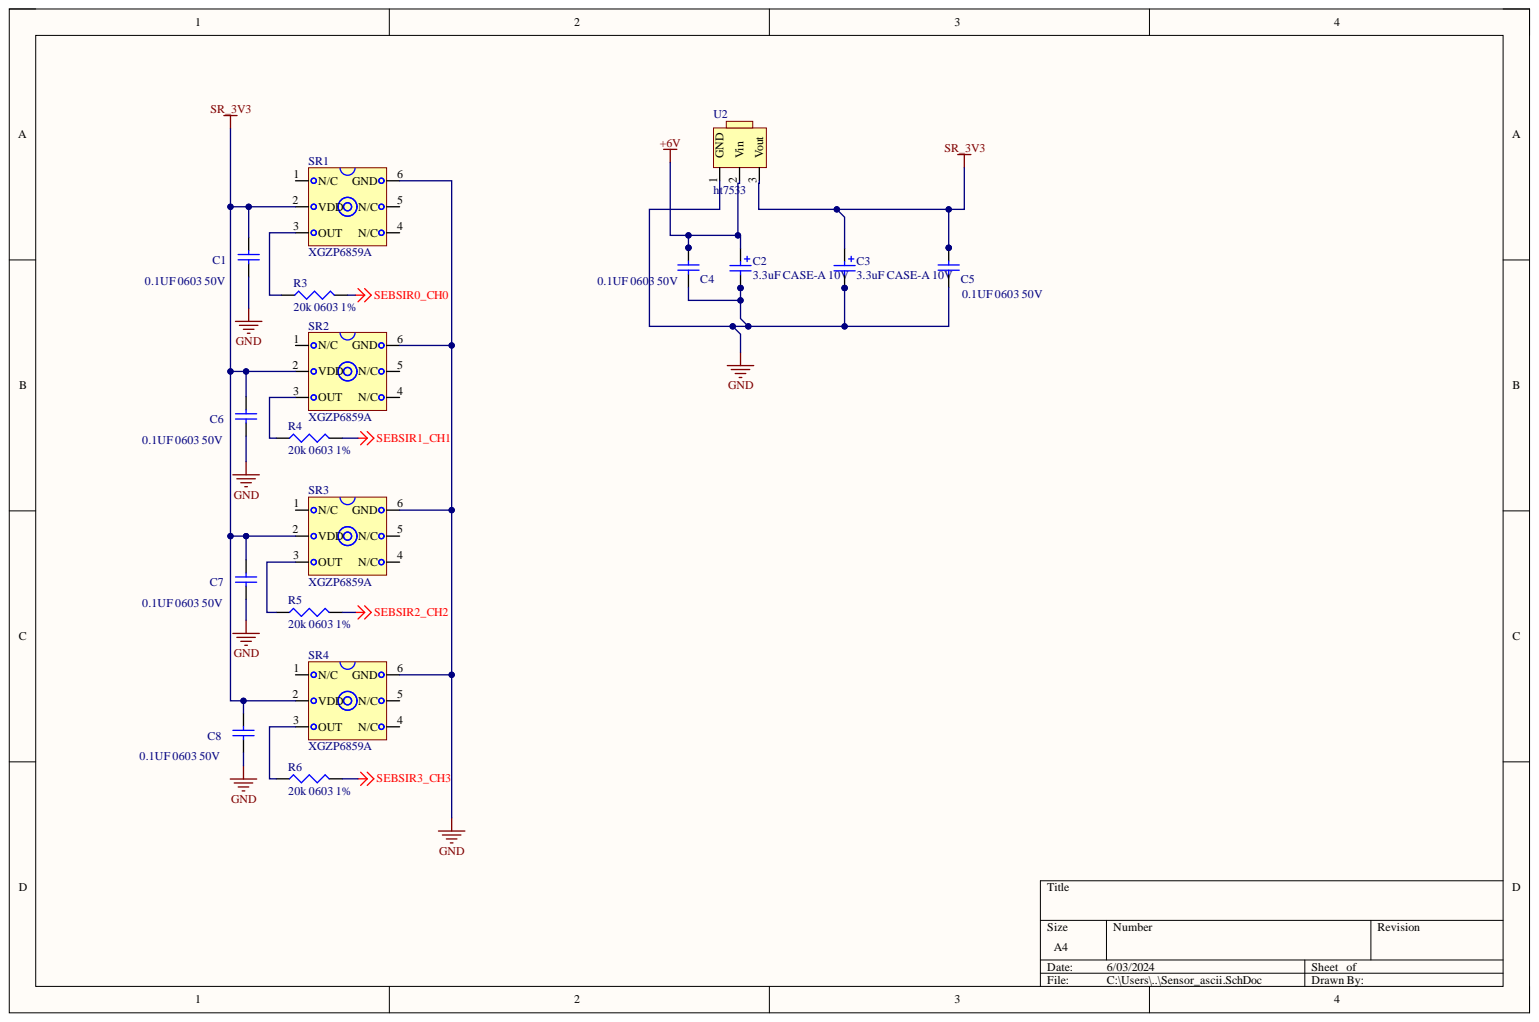
[picture p32: page 2]

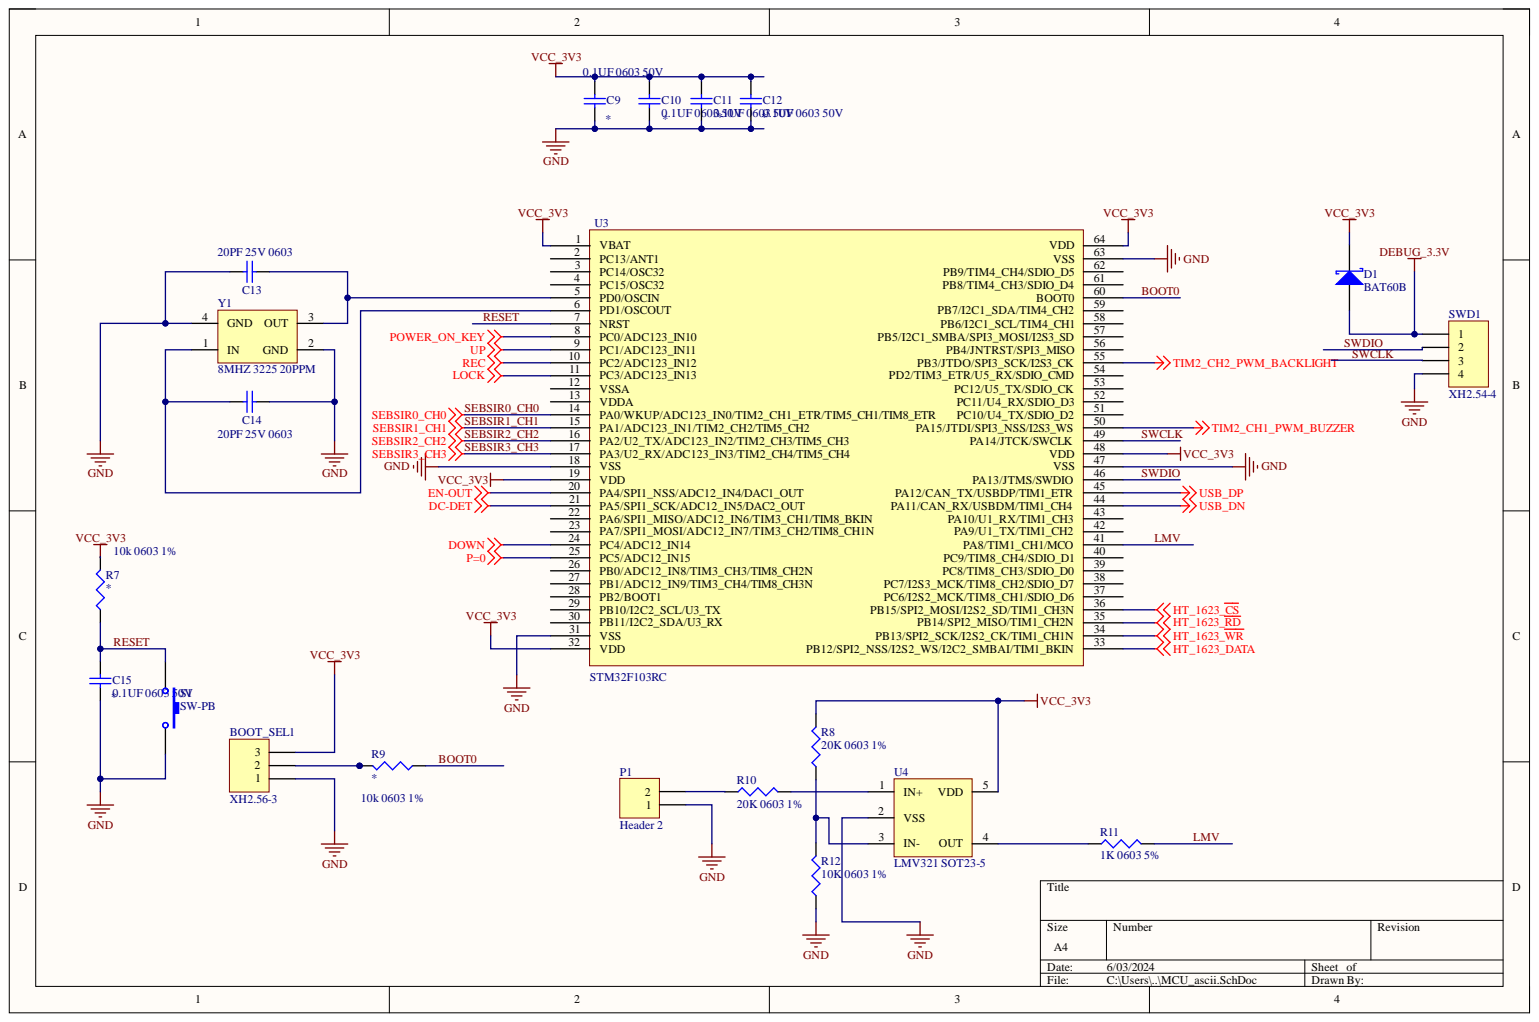
[picture p33: page 3]

PD1/OSCOUT 6
NRST 7 PC0/ADC123_IN10 8 PC1/ADC123_IN11 9 PC2/ADC123_IN12 10 PC3/ADC123_IN13 11 VSSA 12

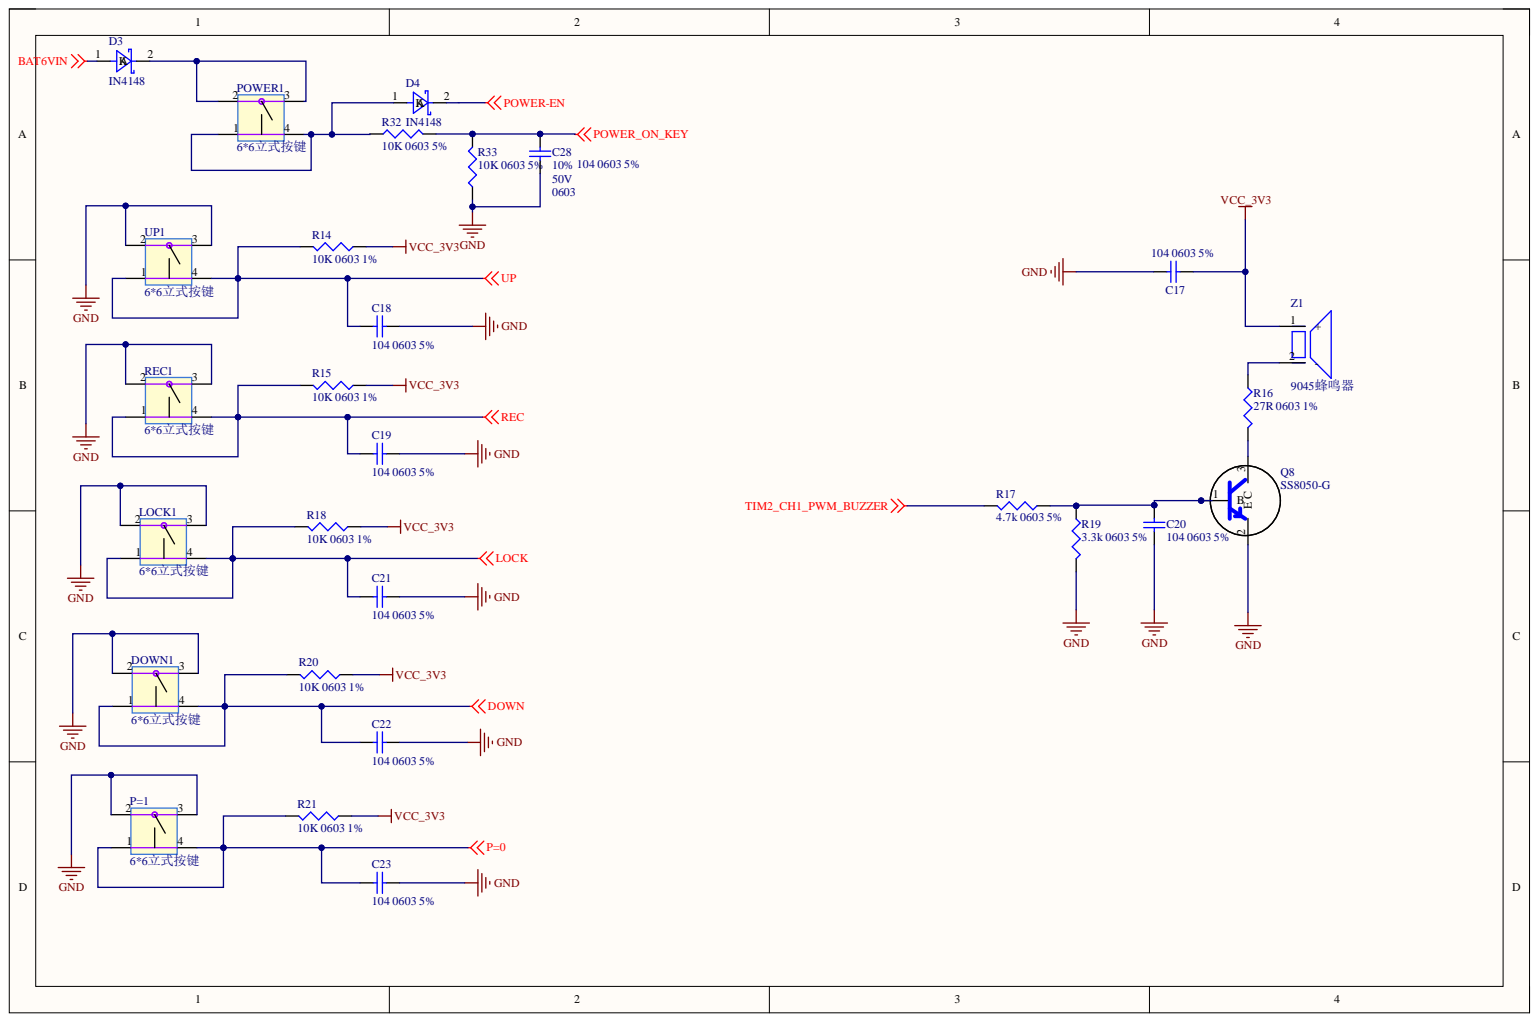
[picture p34: page 4]

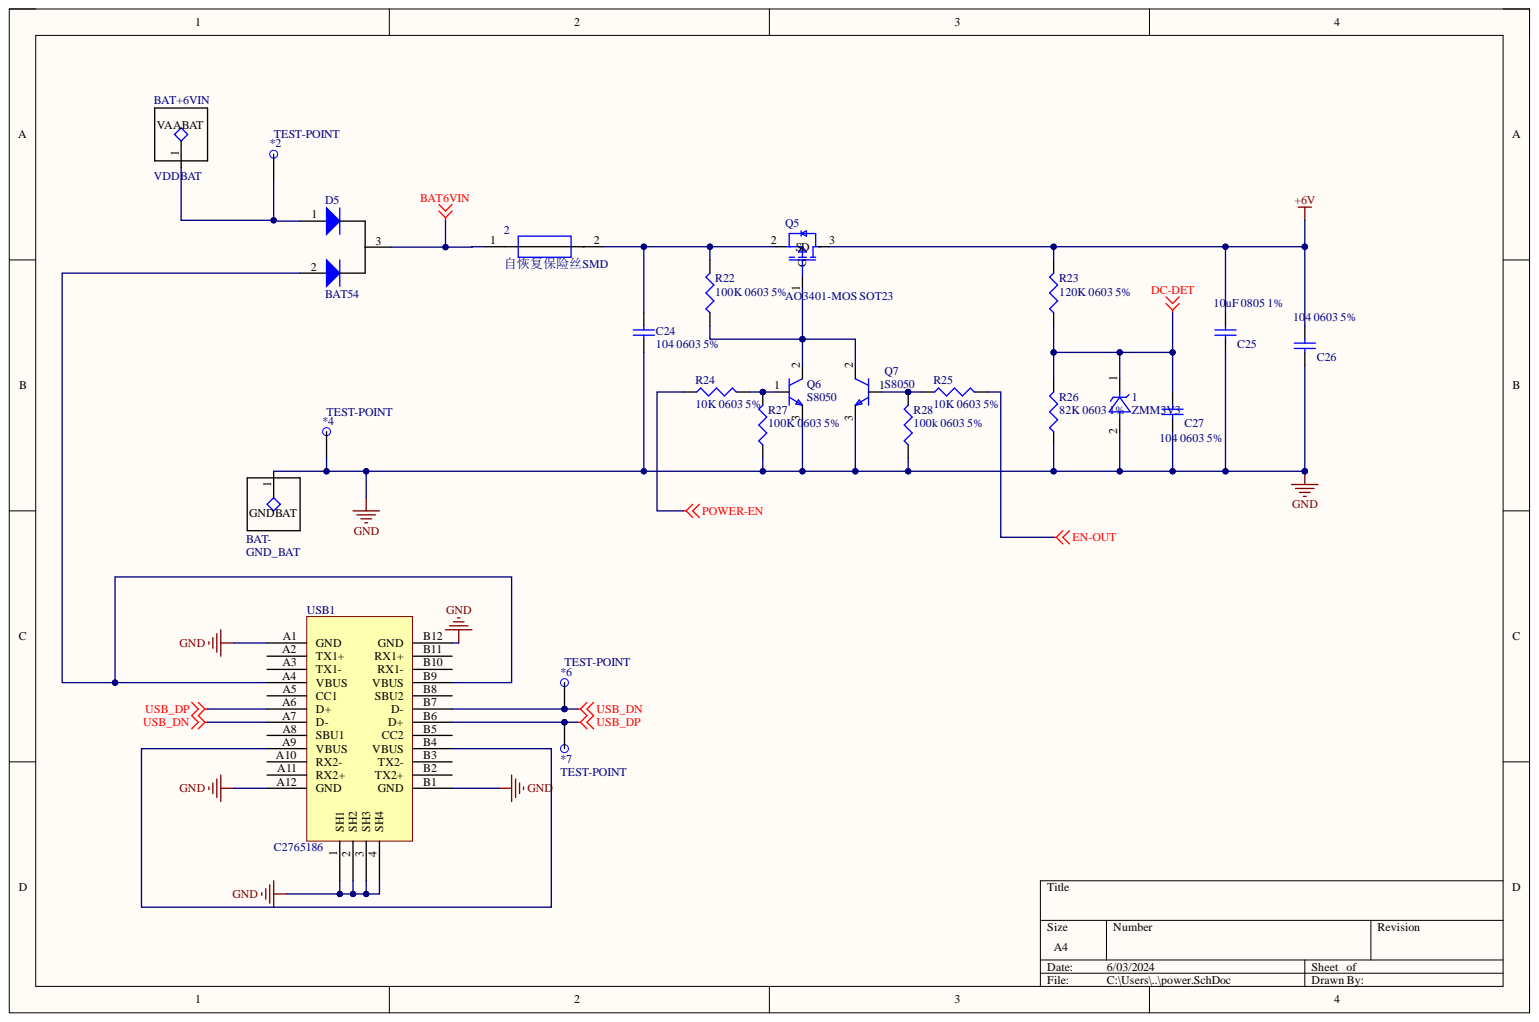
[picture p35: page 5]
