chenhongbin1994/autool/PT50摩托车四缸平衡仪表/HT1623断码屏/TXD-61666(摩托车四通道）.dwg.pdf

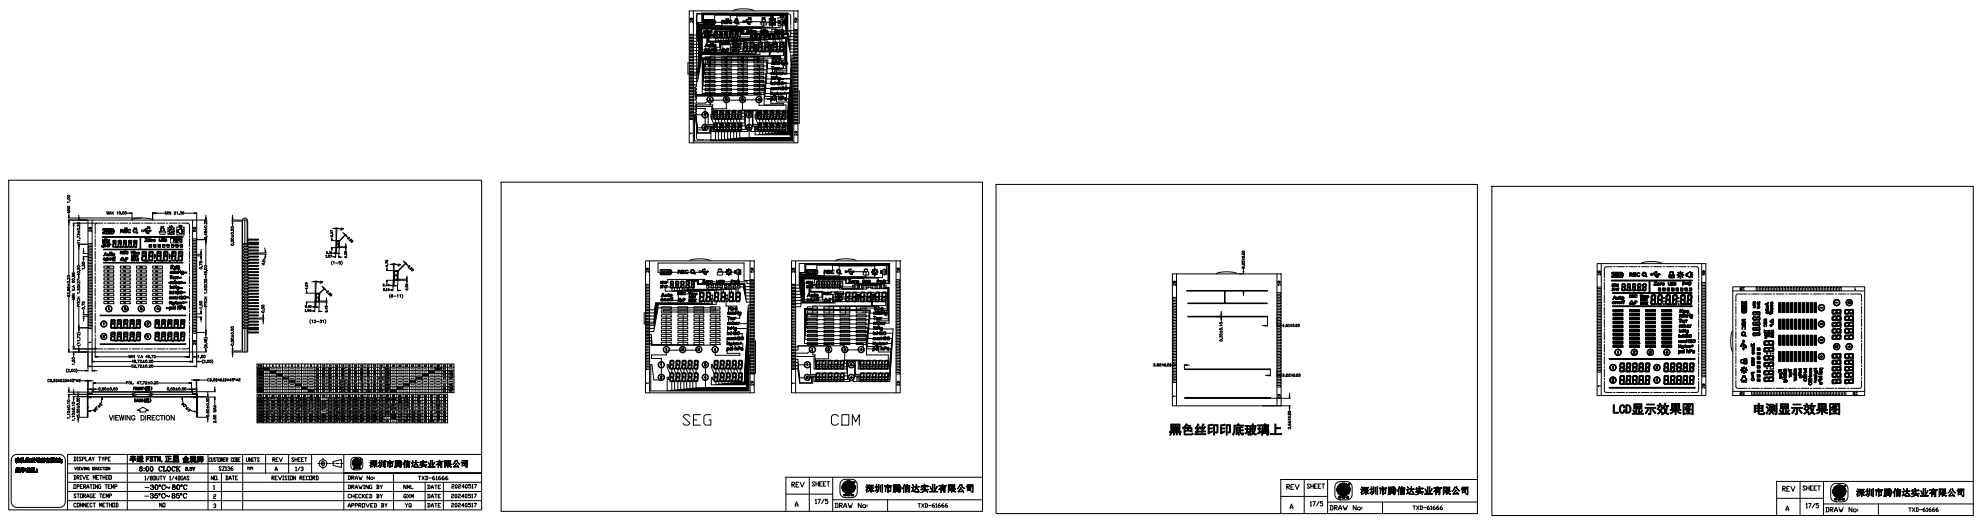
[picture p36: page 1]
