chenhongbin1994/autool/PT50摩托车四缸平衡仪表/HT1623断码屏/TXD-BL23A275W4-S承认书（冷媒表.摩托车四通道）.pdf

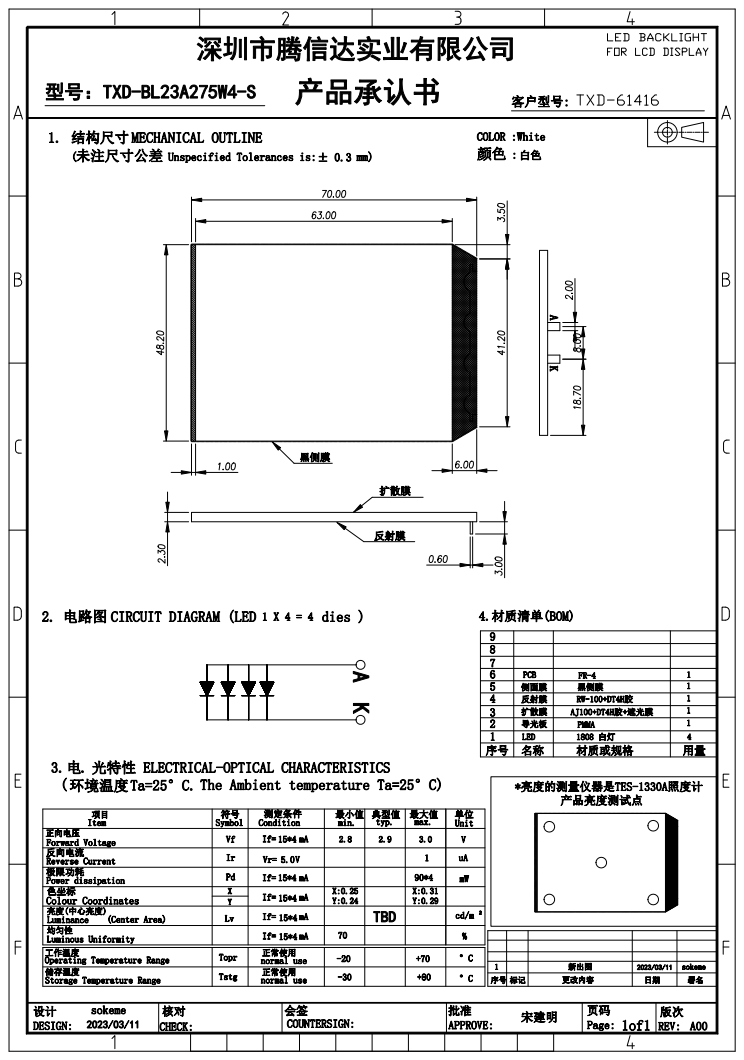
[picture p37: page 1]
