chenhongbin1994/autool/辅助资料/第一版/TXD-61666编码图.pdf

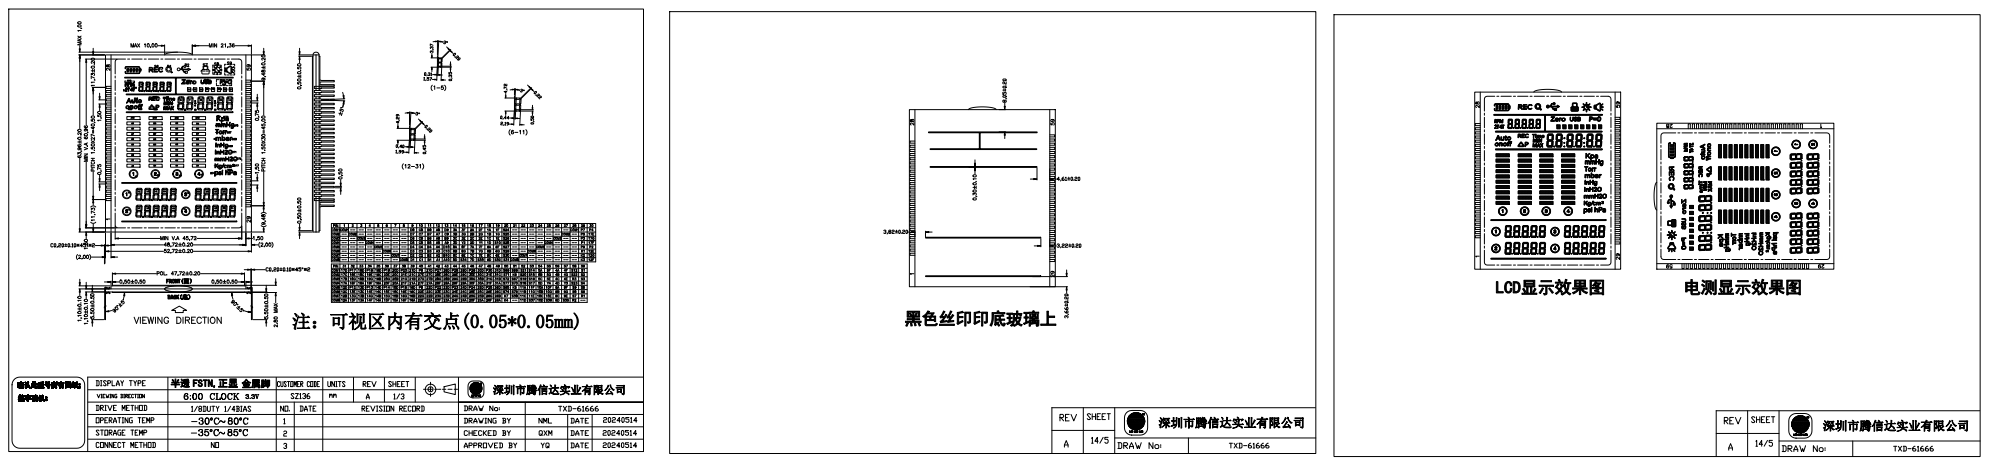
[picture p38: page 1]
