chenhongbin1994/autool/辅助资料/模组驱动/PT50_stmf103_V2/App/main.c

/*********************************************************************************
  * 文件名  ：main.c
 * 描述    ：        
 * 硬件连接：
 * 4针OLED：GND -> GND; VCC -> 3.3V; SCL -> PC4; SDA -> PC5;
 * 压力传感器1：VCC -> 5V; GND -> GND; AO -> PA0; 
 * 压力传感器2：VCC -> 5V; GND -> GND; AO -> PA2; 
 * USB转串口模块：GND -> GND; RX -> PA9; TX -> PA10; 
 * 功能描述：测量气压值HT1625断码屏显示；
             串口接收测量所得的气压值（波特率115200）；
   使用时先进行零点和满量程校准，依据校准值调整 Voltage_0   Voltage_40 
**********************************************************************************/


#include "stm32f10x.h"
#include "delay.h"
#include "usart.h"
#include "adc.h"
#include <stdio.h>
#include <string.h>
#include <math.h>
#include "oled.h"
#include "LED.h"
#include "buzzer.h"
#include "timer.h"

#if 1
extern u8  TIM5CH1_CAPTURE_STA;		//输入捕获状态		    				
extern u16	TIM5CH1_CAPTURE_VAL;	//输入捕获值	
 int main(void)
 {		
 	u32 temp=0; 
	delay_init();	    	 //延时函数初始化	  
	NVIC_PriorityGroupConfig(NVIC_PriorityGroup_2);	 //设置NVIC中断分组2:2位抢占优先级，2位响应优先级
	uart_init(115200);	 //串口初始化为115200
 	LED_Config();			     //LED端口初始化
 
 	TIM3_PWM_Init(899,0); 		//不分频。PWM频率=72000/(899+1)=80Khz
 	TIM5_Cap_Init(0XFFFF,72-1);	//以1Mhz的频率计数 
   	while(1)
	{
 		delay_ms(10);
	
		TIM_SetCompare2(TIM3,TIM_GetCapture2(TIM3)+1);

		if(TIM_GetCapture2(TIM3)==300)TIM_SetCompare2(TIM3,0);	
		 		 
 		if(TIM5CH1_CAPTURE_STA&0X80)//成功捕获到了一次上升沿
		{
			temp=TIM5CH1_CAPTURE_STA&0X3F;
			temp*=65536;//溢出时间总和
			temp+=TIM5CH1_CAPTURE_VAL;//得到总的高电平时间
			printf("HIGH:%d us\r\n",temp);//打印总的高点平时间
			TIM5CH1_CAPTURE_STA=0;//开启下一次捕获
		}
	}
 }
#endif


#if 0
int ADC_Channel0, ADC_Channel2;
float Pressure_V0=0.0, Pressure_V2=0.0;
long pressure0=0, pressure2=0;
uint8_t V_disbuff[2][5]={{0},{0}}; 
uint8_t P_disbuff[2][6]={{0},{0}};


void BEND_Value_Conversion(int ch, int adcValue, float pressure)
	{
		long pressureInt;
    /* 显示电压值 */
    V_disbuff[ch][0] = adcValue / 1000 + '0';
    V_disbuff[ch][1] = (adcValue % 1000) / 100 + '0';
    V_disbuff[ch][2] = (adcValue % 100) / 10 + '0';
    V_disbuff[ch][3] = adcValue % 10 + '0';
    
    /* 显示压力值 */
    pressureInt = (long)(pressure * 1000);  // 转换为 mbar，支持正负值
    if (pressureInt <= -99999) pressureInt = -99999; // 最小压力限制
    if (pressureInt >= 99999) pressureInt = 99999;   // 最大压力限制

    if (pressureInt < 0) {  // 负压力显示
        P_disbuff[ch][0] = '-';
        pressureInt = -pressureInt;
    } else {
        P_disbuff[ch][0] = ' ';
    }

    P_disbuff[ch][1] = pressureInt / 10000 + '0';
    P_disbuff[ch][2] = (pressureInt % 10000) / 1000 + '0';
    P_disbuff[ch][3] = (pressureInt % 1000) / 100 + '0';
    //P_disbuff[ch][4] = (pressureInt % 100) / 10 + '0';
    //P_disbuff[ch][5] = pressureInt % 10 + '0';
}


void Mcu_Init(void)
{
  /* system init */
	//SCB->VTOR = FLASH_BASE | 0x10000; /* Vector Table Relocation in Internal FLASH. */
	SystemInit();
  delay_init();	
  NVIC_Configuration();
  uart_init(115200);
	Adc1_Init();
	LED_Config();
  //Buzzer_Init();//引脚定义PA0，与ADC_0通道冲突
	OLED_Init();
  OLED_ColorTurn(0);
  OLED_DisplayTurn(0);
  OLED_Refresh();
  delay_ms(2500);
  OLED_Clear();
}


int main(void)
{		
		int channelIndex;
		Mcu_Init();
    
    while(1)
    {
        for (channelIndex = 0; channelIndex < 2; channelIndex++) {
            int ch = channelIndex == 0 ? 0 : 2; // 使用通道0和通道2
            int adcValue = ADC1_Mid_GetAverageValue(ch, 10); // 读取每个通道的平均值
            float pressure = ADC1_Mid_MapValue(adcValue, 1.43,0.0125);
						printf("Channel %d: Voltage: %d mV, Pressure: %f mbar\r\n", ch, adcValue, pressure);
            BEND_Value_Conversion(channelIndex, adcValue, pressure);
						LEDR_OPEN();
						delay_ms(2500);
						LEDR_CLOSE();
						
            // 显示第一个通道
            OLED_Clear();
            OLED_ShowString(0, 16, "CH_0:", 16, 0);
            OLED_ShowString(72, 16, V_disbuff[0], 16, 0);
            OLED_ShowString(0, 32, "Pre_0:", 16, 0);
            OLED_ShowString(72, 32, P_disbuff[0], 16, 0);

            // 显示第二个通道
            OLED_ShowString(0, 48, "CH_2:", 16, 0);
            OLED_ShowString(72, 48, V_disbuff[1], 16, 0);
            OLED_ShowString(0, 64, "Pre_2:", 16, 0);
            OLED_ShowString(72, 64, P_disbuff[1], 16, 0);

            OLED_Refresh();
        }
        delay_ms(500);
    }
}
#endif
