chenhongbin1994/autool/辅助资料/断码屏资料/HT1623 (1)/HT1623/MDK-ARM/HT1623/HT1623.c

#include "HT1623.h"

void HT1623_SendBit(unsigned char data,unsigned char cnt)    
{   
  unsigned char i;   
     
  for(i =0; i <cnt; i ++)   
  {   
		HAL_GPIO_WritePin(GPIO_WR,GPIO_PIN_WR,GPIO_PIN_RESET);  
    if(data&0x80) 
			HAL_GPIO_WritePin(GPIO_DATA,GPIO_PIN_DATA,GPIO_PIN_SET);
		else  
			HAL_GPIO_WritePin(GPIO_DATA,GPIO_PIN_DATA,GPIO_PIN_RESET) ;
		
		HAL_GPIO_WritePin(GPIO_WR,GPIO_PIN_WR,GPIO_PIN_SET);  		   
    data<<=1;   
  }   
}   
void HT1623_SendDataBit(unsigned char data,unsigned char cnt)    
{   
  unsigned char i;   
  for(i =0; i <cnt; i ++)   
  {   
		HAL_GPIO_WritePin(GPIO_WR,GPIO_PIN_WR,GPIO_PIN_RESET);  
    if(data&0x01) 
			HAL_GPIO_WritePin(GPIO_DATA,GPIO_PIN_DATA,GPIO_PIN_SET);
		else  
			HAL_GPIO_WritePin(GPIO_DATA,GPIO_PIN_DATA,GPIO_PIN_RESET) ; 
		HAL_GPIO_WritePin(GPIO_WR,GPIO_PIN_WR,GPIO_PIN_SET);  		   
    data>>=1;   
  }   
}   
void HT1623_SendCmd(unsigned char command)   
{   
	HAL_GPIO_WritePin(GPIO_CS,GPIO_PIN_CS,GPIO_PIN_RESET);
  HT1623_SendBit(0x80,3);     //д??????"100"   
  HT1623_SendBit(command,9);  //д??9 λ????,?????8 λ?command ????,???1 λ????   
	HAL_GPIO_WritePin(GPIO_CS,GPIO_PIN_CS,GPIO_PIN_SET);
}  
void HT1623_Write(unsigned char addr,unsigned char data)   
{   
  HAL_GPIO_WritePin(GPIO_CS,GPIO_PIN_CS,GPIO_PIN_RESET);   
  HT1623_SendBit(0xa0,3);     //3位"101"   
  HT1623_SendBit(addr<<1,7);  //7位7 λaddr   
  HT1623_SendDataBit(data,4); //4位data ???4 λ   
  HAL_GPIO_WritePin(GPIO_CS,GPIO_PIN_CS,GPIO_PIN_SET);  
}   
void HT1623_WriteAll(unsigned char addr, unsigned char *p, unsigned char cnt)   
{   
  unsigned char i;   
     
  HAL_GPIO_WritePin(GPIO_CS,GPIO_PIN_CS,GPIO_PIN_RESET);      
  HT1623_SendBit(0xa0,3);     //д??????"101"   
  HT1623_SendBit(addr<<1,7);  //д??7 λaddr   
  for(i =0; i <cnt; i ++)     //????д??????   
  {   
    HT1623_SendDataBit(*p++,8);   
       
  }   
  HAL_GPIO_WritePin(GPIO_CS,GPIO_PIN_CS,GPIO_PIN_SET);  
}      
void HT1623_Init(void)   
{   
//  HT1623_SendCmd(0xE3); //LCD普通模式
	HT1623_SendCmd(0x29); //LCD偏置1/3 4COMS
//	HT1623_SendCmd(0x18);//使用内部振荡器
//	HT1623_SendCmd(0x00);//关闭系统时钟和 LCD 偏置发生器 
	HT1623_SendCmd(0x01);//打开系统时钟 
//	HT1623_SendCmd(0x02);//关闭 LCD 偏置发生器 
	HT1623_SendCmd(0x03);//打开 LCD 偏置发生器  
   
} 


//封装
void Clear()					//清屏函数
{
   unsigned int  i;
   for(i=2;i<74;i++) 
   HT1623_Write(i,0x00);  
}
void Full()				 	//全显示函数
{
   unsigned int  i;
   for(i=2;i<74;i++) 		
   HT1623_Write(i,0xff);  
} 

void display_nb(unsigned char nb1,unsigned char nb2)//nb1 第几位数字  nb2 数字显示几( nb1 范围1-12  12个位置；nb2范围0-10  10为清空)
{
	unsigned int i=1;
	switch(nb1) 
			  {
					case 1:	i=8;break;
					case 2:	i=12;break;
					case 3:	i=16;break;
					case 4:	i=20;break;
					case 5:	i=24;break;
					case 6:	i=28;break;
					case 7:	i=66;break;
					case 8:	i=62;break;
					case 9:	i=58;break;
					case 10:i=52;break;
					case 11:i=48;break;
					case 12:i=44;break;					
			  }
	if(nb1>=1&&nb1<=6)
	{		
		switch(nb2) 
			  {
			    case 0:	HT1623_Write(i,0x0f);HT1623_Write(i+1,0x0f);HT1623_Write(i+2,0x0a);break;
					case 1:	HT1623_Write(i,0x00);HT1623_Write(i+1,0x00);HT1623_Write(i+2,0x0a);break;
					case 2:	HT1623_Write(i,0x0a);HT1623_Write(i+1,0x0f);HT1623_Write(i+2,0x07);break;
					case 3:	HT1623_Write(i,0x02);HT1623_Write(i+1,0x0f);HT1623_Write(i+2,0x0f);break;
					case 4:	HT1623_Write(i,0x04);HT1623_Write(i+1,0x00);HT1623_Write(i+2,0x0f);break;
					case 5:	HT1623_Write(i,0x07);HT1623_Write(i+1,0x0f);HT1623_Write(i+2,0x0C);break;
					case 6:	HT1623_Write(i,0x0f);HT1623_Write(i+1,0x0f);HT1623_Write(i+2,0x0C);break;
					case 7:	HT1623_Write(i,0x02);HT1623_Write(i+1,0x00);HT1623_Write(i+2,0x0a);break;
					case 8:	HT1623_Write(i,0x0f);HT1623_Write(i+1,0x0f);HT1623_Write(i+2,0x0F);break;
					case 9:	HT1623_Write(i,0x06);HT1623_Write(i+1,0x0f);HT1623_Write(i+2,0x0F);break;	
					case 10:HT1623_Write(i,0x00);HT1623_Write(i+1,0x00);HT1623_Write(i+2,0x00);break;	//写空白					
			  }
	}
	else
	{
		switch(nb2) 
			  {
			    case 0:	HT1623_Write(i,0x0a);HT1623_Write(i+2,0x0f);HT1623_Write(i+3,0x0f);break;
					case 1:	HT1623_Write(i,0x0a);HT1623_Write(i+2,0x00);HT1623_Write(i+3,0x00);break;
					case 2:	HT1623_Write(i,0x0c);HT1623_Write(i+2,0x06);HT1623_Write(i+3,0x0f);break;
					case 3:	HT1623_Write(i,0x0f);HT1623_Write(i+2,0x02);HT1623_Write(i+3,0x0f);break;
					case 4:	HT1623_Write(i,0x0f);HT1623_Write(i+2,0x08);HT1623_Write(i+3,0x00);break;
					case 5:	HT1623_Write(i,0x06);HT1623_Write(i+2,0x0a);HT1623_Write(i+3,0x0f);break;
					case 6:	HT1623_Write(i,0x06);HT1623_Write(i+2,0x0f);HT1623_Write(i+3,0x0f);break;
					case 7:	HT1623_Write(i,0x0a);HT1623_Write(i+2,0x00);HT1623_Write(i+3,0x0f);break;
					case 8:	HT1623_Write(i,0x0f);HT1623_Write(i+2,0x0f);HT1623_Write(i+3,0x0f);break;
					case 9:	HT1623_Write(i,0x0f);HT1623_Write(i+2,0x0a);HT1623_Write(i+3,0x0f);break;
					case 10:HT1623_Write(i,0x00);HT1623_Write(i+2,0x00);HT1623_Write(i+3,0x00);break;//写空白
				}
	}
}
void display_point(unsigned char nb,unsigned char enable)//nb  第几个点    enable 使能（nb  范围0-13 ）
{
	if(enable)
	{
		switch(nb) 
		{
			case 0:	HT1623_Write(31,0xf);break;
			case 1:	HT1623_Write(11,0xf);break;
			case 2:	HT1623_Write(15,0xf);break;
			case 3:	HT1623_Write(19,0xf);break;
			case 4:	HT1623_Write(23,0xf);break;
			case 5:	HT1623_Write(27,0xf);break;
			case 6:	HT1623_Write( 5,0xf);break;
			case 7:	HT1623_Write(67,0xf);break;
			case 8:	HT1623_Write(63,0xf);break;
			case 9:	HT1623_Write(59,0xf);break;
			case 10:HT1623_Write(53,0xf);break;
			case 11:HT1623_Write(49,0xf);break;	
			case 12:HT1623_Write( 3,0xf);break;
			case 13:HT1623_Write(45,0xf);break;					
		}
	}
	else
	{
		switch(nb) 
		{
			case 0:	HT1623_Write(31,0x00);break;
			case 1:	HT1623_Write(11,0x00);break;
			case 2:	HT1623_Write(15,0x00);break;
			case 3:	HT1623_Write(19,0x00);break;
			case 4:	HT1623_Write(23,0x00);break;
			case 5:	HT1623_Write(27,0x00);break;
			case 6:	HT1623_Write( 5,0x00);break;
			case 7:	HT1623_Write(67,0x00);break;
			case 8:	HT1623_Write(63,0x00);break;
			case 9:	HT1623_Write(59,0x00);break;
			case 10:HT1623_Write(53,0x00);break;
			case 11:HT1623_Write(49,0x00);break;	
			case 12:HT1623_Write( 3,0x00);break;
			case 13:HT1623_Write(45,0x00);break;
		}
	}
}
void display_piece(unsigned char nb,unsigned char enable)//nb  第几个块    enable 使能（nb  范围1-89 ）
{
	if(enable)
	{
		switch(nb)
		{
			case 1: HT1623_Write(2,0x8);break;
			case 2: HT1623_Write(2,0x4);break;
			case 3: HT1623_Write(2,0x2);break;
			case 4: HT1623_Write(2,0xc);break;
			case 5: HT1623_Write(2,0xa);break;
			case 6: HT1623_Write(2,0x6);break;
			case 7: HT1623_Write(2,0xe);break;
			case 8: HT1623_Write(4,0x8);break;
			case 9: HT1623_Write(4,0x4);break;
			case 10:HT1623_Write(4,0x2);break;
			case 11:HT1623_Write(4,0xc);break;
			case 12:HT1623_Write(4,0xa);break;
			case 13:HT1623_Write(4,0x6);break;
			case 14:HT1623_Write(4,0xe);break;
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
		display_piece(T15,0);
		display_piece(T17,0);
		display_piece(T19,0);
		display_piece(T1,1);
		display_piece(nb,1);
	}
	else
	{
		display_piece(T1,0);
		display_piece(T2,0);
		display_piece(T4,0);
		display_piece(T6,0);
		display_piece(T9,0);
		display_piece(T11,0);
		display_piece(T14,0);
		display_piece(T16,0);
		display_piece(T18,0);
		display_piece(T20,0);
		display_piece(T22,0);
		display_piece(T13,0);
		display_piece(T5,0);
		display_piece(T7,0);
		display_piece(T8,0);
		display_piece(T10,0);
		display_piece(T11,0);
		display_piece(T12,0);
		display_piece(T13,0);
		display_piece(T15,0);
		display_piece(T17,0);
		display_piece(T19,0);
	}
}
