chenhongbin1994/autool/PT50摩托车四缸平衡仪表/软件工程/前版本/PT50_APP_V1.0未改需求/MyCode/BUZ/buzzer.h

#ifndef __BUZZER_H
#define __BUZZER_H

#include "typedefs.h"
#include "stm32f10x.h"
#include "stm32f10x_tim.h"
#include "stm32f10x_rcc.h"
#include "stm32f10x_gpio.h"

void Buzzer_Init(void);
void Buzzer_On(void);
void Buzzer_Off(void);	
void Buzzer_SetFrequency(uint16_t frequency);
void Key_Beep(void);
//void Bz_Key(void);

#endif
