chenhongbin1994/autool/PT50摩托车四缸平衡仪表/软件工程/前版本/PT50_APP_V1.0未改需求/MyCode/LCD/display.c

/*
 * @Author: ChenHongBin 944278386@qq.com
 * @Date: 2024-06-19 15:44:42
 * @LastEditors: ChenHongBin 944278386@qq.com
 * @LastEditTime: 2024-07-03 15:02:16
 * @FilePath: \Projectc:\Users\IBM\Desktop\PT50_stmf103_ADC_V16cs\MyCode\LCD\display.c
 * @Description: 这是默认设置,请设置`customMade`, 打开koroFileHeader查看配置 进行设置: https://github.com/OBKoro1/koro1FileHeader/wiki/%E9%85%8D%E7%BD%AE
 */
/********************************************

********************************************/
#include "display.h"
#include "digit.h"
#include "display.h"
#include "LCD_HT1623.h"
//#include "power.h"
