chenhongbin1994/autool/(commit log)

2024-08-21 改完需求的一个版本V2.0
    [Dispay Code-46R065 16NSOP.OBJ, HT1623.xlsx, PT50 摩托车四缸平衡仪buglist_20240810.xlsx, TXD-61666编码图.dwg, TXD-BL23A275W4-S承认书.dwg, ht1621.OBJ, main.OBJ, xgzp6859a精度测试20240521.xlsx]
2024-08-27 8.27更新完整功能
